canerpotur/TROY-TECH/Spring Semester Test Results/08_04_2019_VideoTransmission_IndoorRangeTest_Successful.JPG

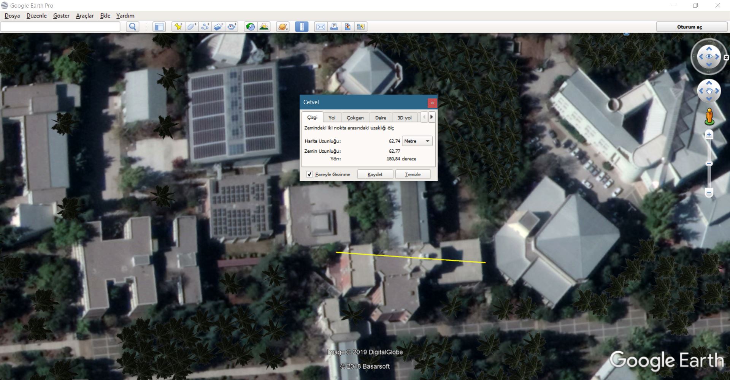
Spring Semester Test Results/08_04_2019_VideoTransmission_IndoorRangeTest_Successful.JPG
