canerpotur/TROY-TECH/Tests/Range performance  Video+command  tests/Photos (Google Earth)/D_E_command.JPG

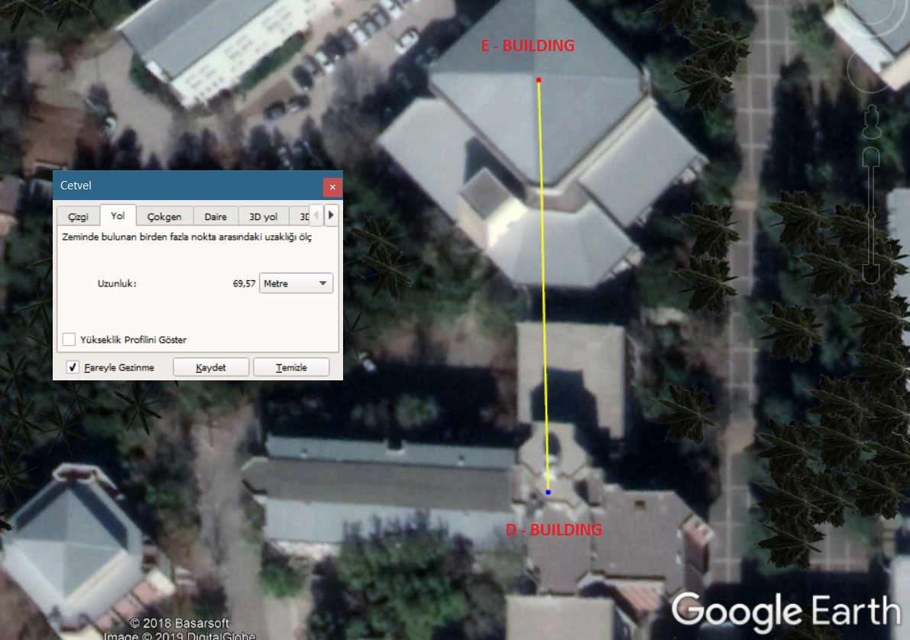
Tests/Range performance Video+command tests/Photos (Google Earth)/D_E_command.JPG
