canerpotur/TROY-TECH/README.md

# TROY-TECH
METU EE 2018-2019 GRADUATION PROJECT
