canerpotur/TROY-TECH/Demo/motor/useful link for motor drive.txt

https://howtomechatronics.com/tutorials/arduino/arduino-dc-motor-control-tutorial-l298n-pwm-h-bridge/
