canerpotur/TROY-TECH/Searches/Wireless Transmission/HC-12/links.txt

https://forum.arduino.cc/index.php?topic=499210.0
