canerpotur/TROY-TECH/Weekly Reports/Week4(October29-November6)/TroyTech-WeeklyReport4.docx

MIDDLE EAST TECHNICAL UNIVERSITY

DEPARTMENT OF ELECTRICAL & ELECTRONICS ENGINEERING


TROY TECH

WEEKLY REPORT #4

29.10.2018-06.11.2018

Section : 7

Studio Coordinator: Mustafa Mert ANKARALI

Partners :

Hasan ÖZKARA - 2031888

Kağan ÖZASLAN - 2031854

Caner POTUR - 2031250

Mustafa Ercan OKATAN - 2031193

Mert KAYIŞ – 2030997

Progresses for Previous Week:

→ We started working on the proposal report that we will submit on November 9th. Firstly, we tried to understand the function of the proposal report, we discussed about how the outline of the proposal report should be. We discussed on the description of proposal report on the course website.

→ We distributed the main parts of the work load to our group members according to their tendancies about parts of the project such as wireless communication, motor driving units and mechanics. As shown in Table 1, we tried to share the total work load of the project.

Table 1: Distribution of the work load between group members.

| Main Option | Secondary Option
Caner POTUR | Video Transmission | Command Transfer
Mert KAYIŞ | Video Transmission | Command Transfer
Mustafa Ercan OKATAN | Mechanics | Command Transfer
Hasan ÖZKARA | Motor Drive | Mechanics
Kağan ÖZASLAN | Command Transfer | Motor Drive

Plans for the Next Week:

We are planning to order some hardware parts related to video transmission unit (camera and the necessary units for wireless transfer of the data image) in the following week in order to observe real-life behavior of the stuff that we want to include in our project.

Until Friday, we are going to complete working on deliverables and possible outcomes of the project, tentative cost-budget analysis, Gantt chart (time plan for the rest of the project). Finally, we will submit our proposal report on time.
