canerpotur/TROY-TECH/Troy Tech - Presentation/TROY - Kağan.pptx

## KAĞAN ÖZASLAN CFO

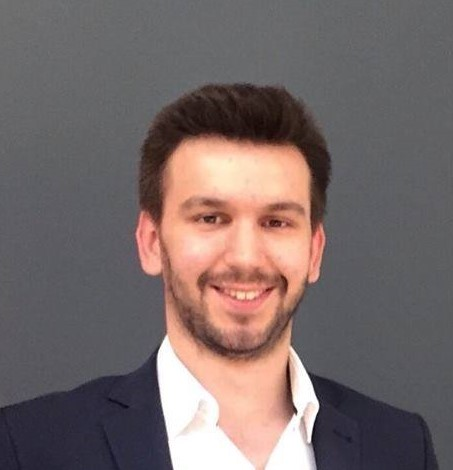
[picture p66: figure]

## Slide 2

- Video Transmission
- Command Transmission

## Video Transmission

- 5.8 Ghz
- 600mw Transmitter (TS5828)
- 40 Channel
- 27.5 dBm
- 170 degree camera

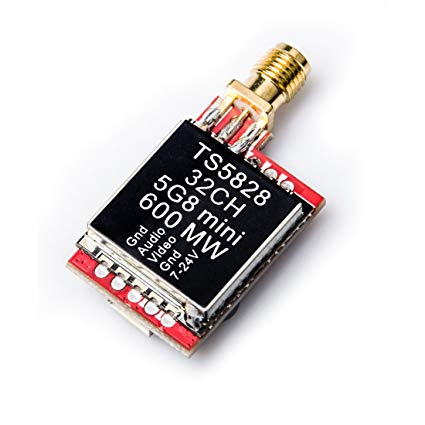
[picture p67: figure]
ts5828 ile ilgili gÃ¶rsel sonucu
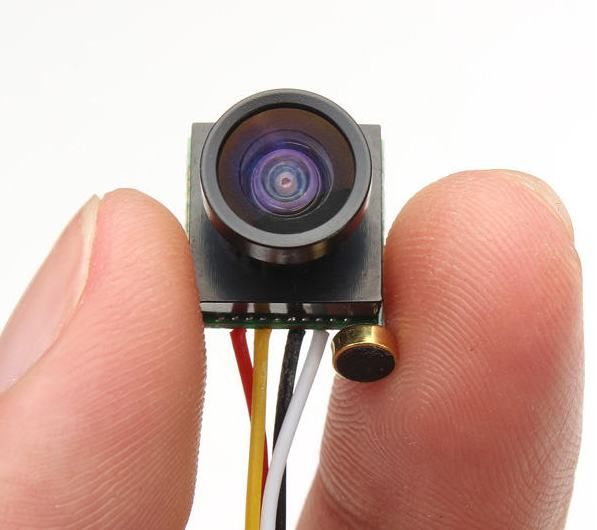
[picture p68: figure]
nesne içeren bir resim Yüksek güvenilirlikle oluşturulmuş açıklama

## Video Transmission

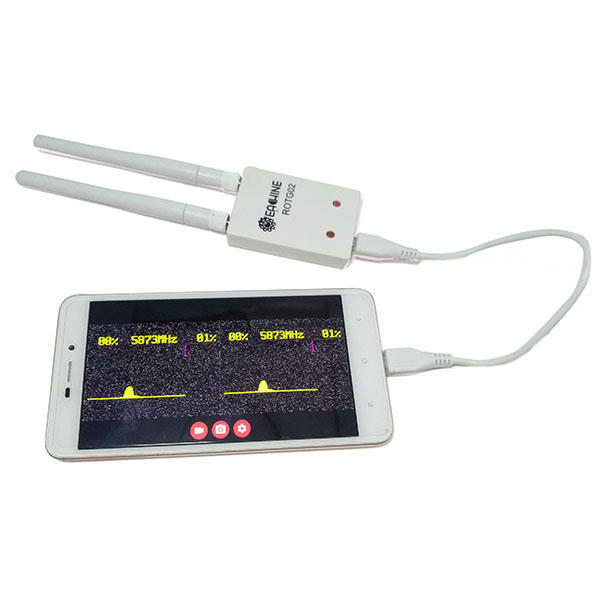
[picture p69: figure]

- 5.8 Ghz Receiver (ROTG02)
- Easy to use
- Plug and Play with usb cable
- 150 Channel

## Test Results

- Outdoor = 500 m
- Indoor = 50 m (from E Building Top Floor to D Building Study Hall)

## Test Results

- Outdoor = 500 m
- Indoor = 50 m (from E Building Top Floor to D Building Study Hall)
- Improvement Option
  - 5.8G Amplifier
  - 27dBm to 34 dBm

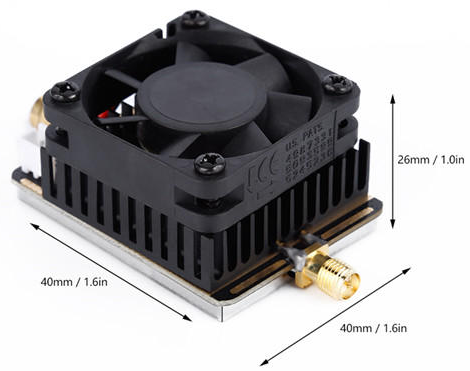
[picture p70: figure]

## Command Transmission

- 2.4Ghz band
- NRF24L01+ module
  - Very cheap (less than $2)
  - Compatible with high gain antennas
  - 2.4ghz antennas are also very cheap
  - Secure communication protocol
  - 100mW, legal to use

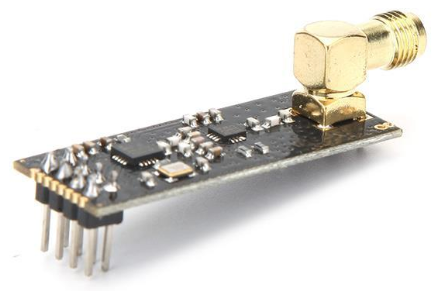
[picture p71: figure]

## Command Transmission

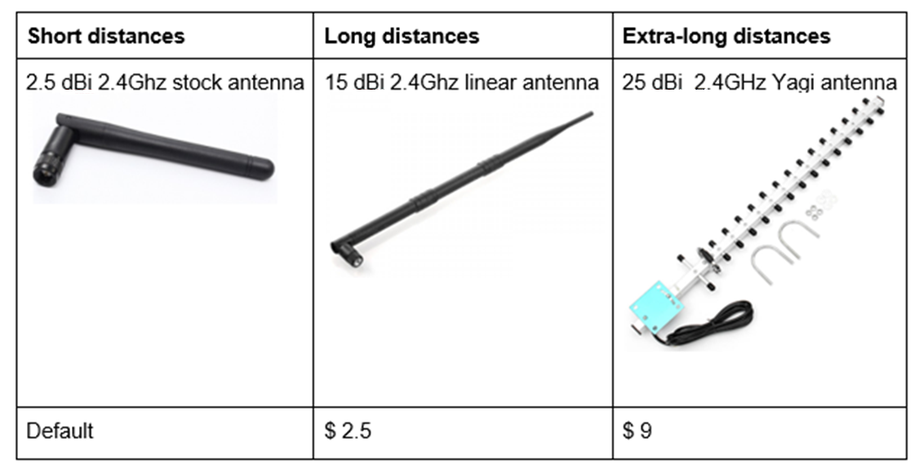
[picture p72: figure]

## Test Results

- NRF modules with 15dBi Linear Antennas
- Outdoor = 1 km
- Indoor = 100 m

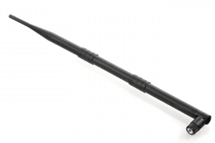
[picture p73: figure]

## Communication Protocol

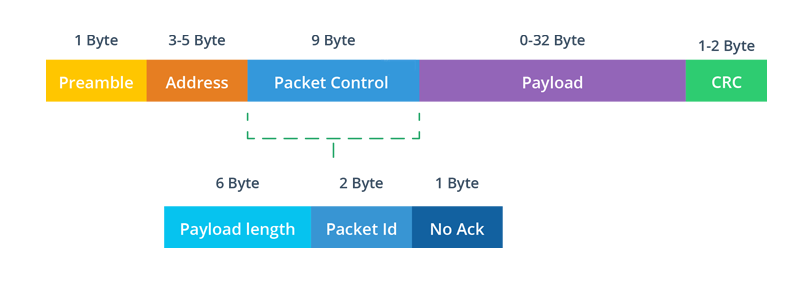
[picture p74: figure]

## Slide 11

Preamble: Shows beginning of a packet.
Address: Shows the network pipe address.
Packet Control: Settings section.
Payload: Sending data is stored inside. Upon 32 byte.
CRC: Cyclic redundancy check for error detection.

## User Side

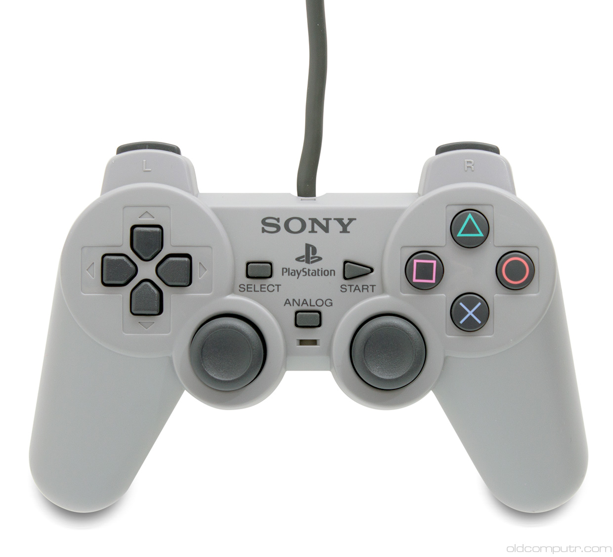
[picture p75: figure]
gök, iç mekan içeren bir resim Yüksek güvenilirlikle oluşturulmuş açıklama
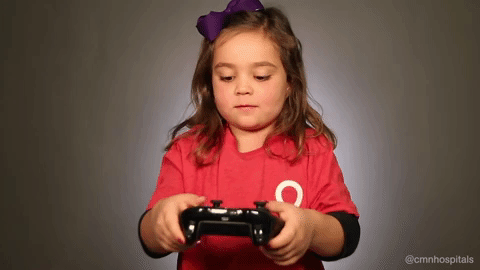
[picture p76: figure]
Video Games Kids GIF by Children's Miracle Network Hospitals
