canerpotur/TROY-TECH/Troy Tech - Presentation/TROY Mert.pptx

CONCEPTUAL DESIGN
PRESENTATION

## MERT KAYIŞ COO

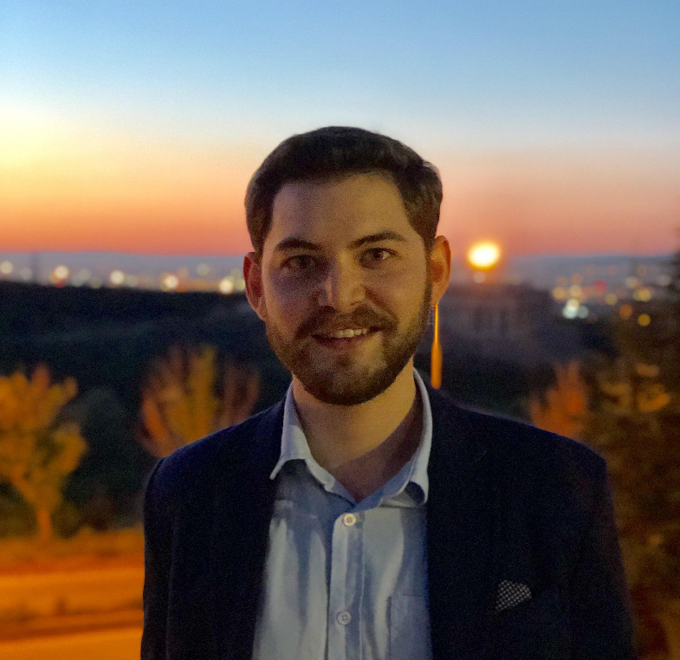
[picture p77: figure]

## Overall Block Diagram

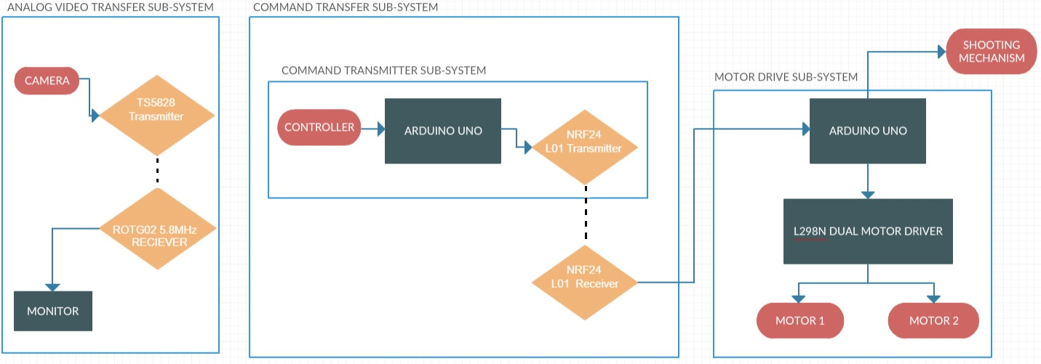
[picture p78: figure]

## Flowchart for Video Transfer Subsystem

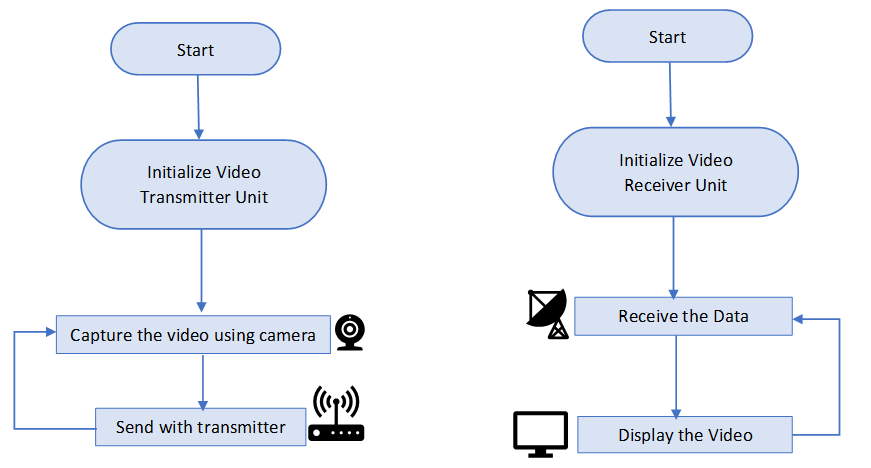
[picture p79: figure]

Continuous operation

Continuous operation

## Flowchart for the Command Transfer Subsystem

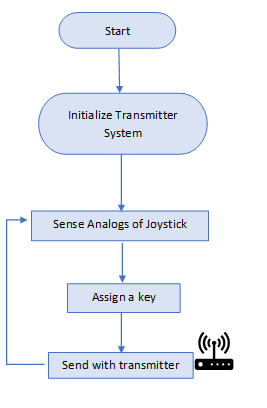
[picture p80: figure]

## Flowchart for the Command Transfer Subsystem

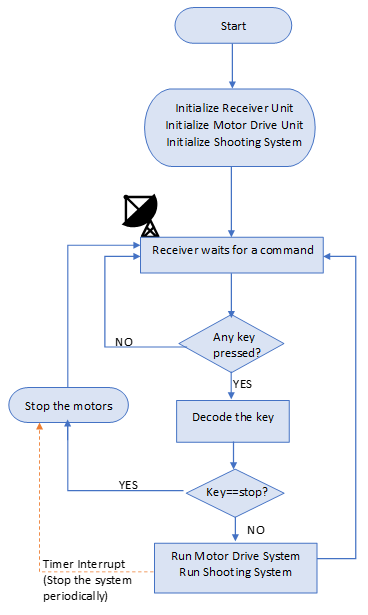
[picture p81: figure]

## Power Supply Unit

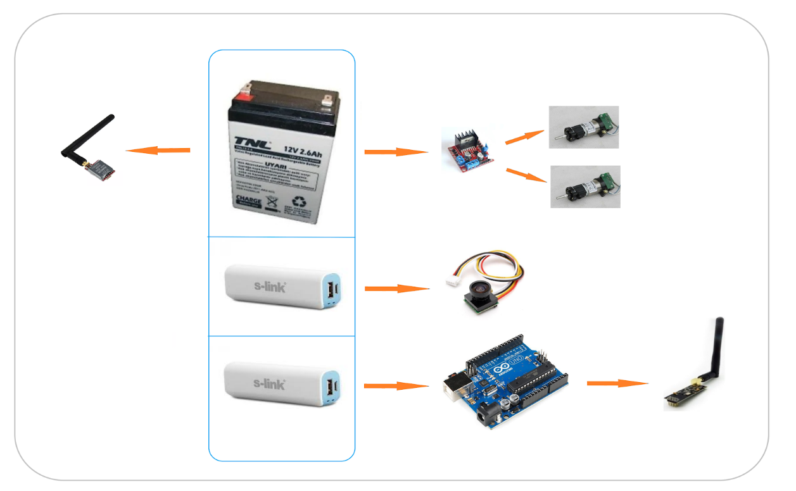
[picture p82: figure]
