canerpotur/TROY-TECH/Troy Tech - Presentation/TROY- Hasan OZKARA.pptx

CONCEPTIAL DESIGN
PRESENTATION

## Hasan ÖZKARA -CEO-

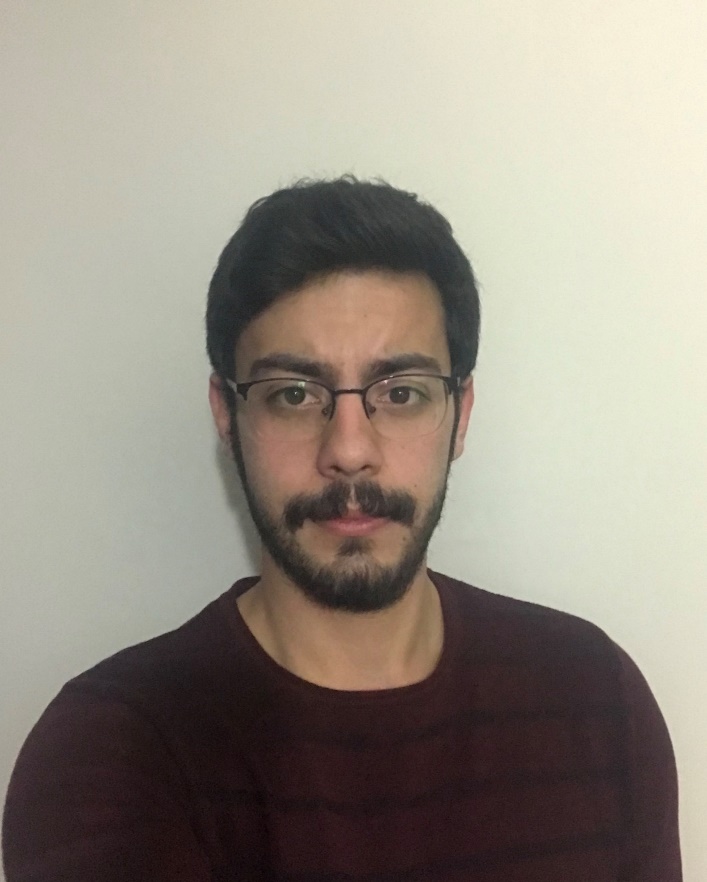
[picture p83: figure]

## Outline of the Presentation

- Company Description
- Introduction
- Overall Block Diagram
- System Level Flowchart
- Power Supply Unit
- Video Transmission
- Command Transmission

## Slide 4

Company Description

## Members of the Company

TROY TECH
CEO
Hasan ÖZKARA
COO
Mert KAYIŞ
CFO
Kağan ÖZASLAN
CMO
Mustafa Ercan OKATAN
CTO
Caner POTUR

## Mission & Vision

- Mission: Our mission is to design and produce creative and reliable electronic Technologies and robotics meeting the desired specifications of customers under limited budget and time.
- Vision: Our vision is to be a unique company consisting of highly motivated R&D engineers that create impressive robotic products with affordable and reasonable costs.

## Product – Helen V

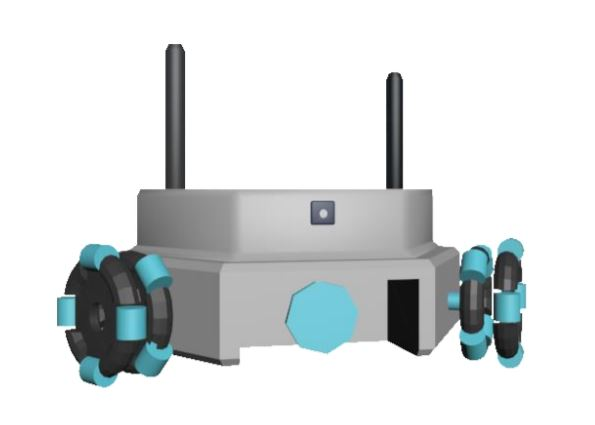
[picture p84: figure]

## Slide 8

Introduction

## Problem Statement

- Controlling the ball
- Shooting the ball to opponent’s goal
- Defending the ball coming from opponent

## Restrictions & Constraints

- Teleoperation from at least 30 meters
- Remote control
- No crossing to the center-line
- No touching to the opponent
- Ball transfer to opponent’s field in 20 seconds
- Only hitting or pushing the ball
- Robot fitting into cylinder of diameter 65cm
- Maximum budget of $200
