canerpotur/TROY-TECH/Searches/DEVICES.docx

DEVICES:

1)

5.8Ghz 600mW FPV transmitter and receiver are seen suitable for our project. Only question is, are they supposed to work indoor? But it most probably could work indoor as well because 600mW transmitter gives 1-2 km range in the open area. It has different channels so that the video cannot be mixed with others broadcast.

This is transmitter and receiver kit is about $25 at aliexpress link (https://tr.aliexpress.com/item/FPV-5-8Ghz-600mW-TS5828-or-TS832-Transmitter-48CH-RC832-plus-Receiver-With-A-V-and/32813251539.html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).

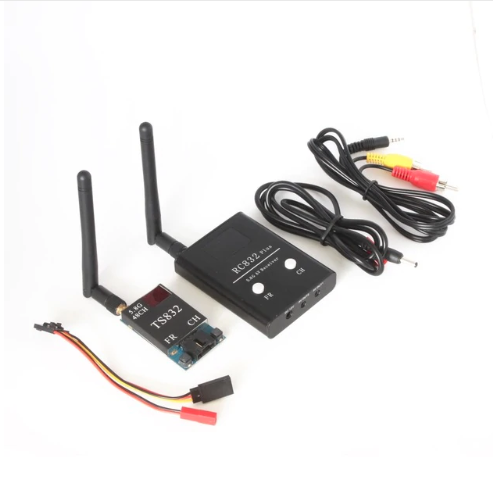
[picture p85: figure]

UPDATE:

We’ve orderred ROTG02 from bangood.com as $21. Order date: 12.11.2018

https://www.banggood.com/Eachine-ROTG02-UVC-OTG-5_8G-150CH-Dual-Antenna-Audio-FPV-Receiver-for-Android-Tablet-Smartphone-p-1242422.html?ID=224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

Here is some testing examples of it.

https://www.youtube.com/watch?v=I2rOh4Psi1I

2) OMNI WHEEL

We can use omniwheel for our robot to be able to capable for moving all directions. There is some example video and brief introduction below about omniwheel and also a detailed article is attached into the TROY-TECH\Searches folder. There may be some issues by using omniwheel; it increases expenses directly and omni wheels are not cheap. We also should handle controlling them, maybe with a feedback control system.

1st video : https://www.youtube.com/watch?v=_tmiu1wpp_E

2nd video : https://www.youtube.com/watch?v=H29PEOTDFA4

Here is brief introduction of omni-wheel technology.

Omni-directional wheels are unique as they are able to roll freely in two directions .It can ether roll like a normal wheel or roll laterally using the wheels along its circumference.Omni-direction wheels allow a robot to convert from a non-holonomic to a holonomic robot.A non-holonomic robot that uses normal wheels has only 2 out of 3 controllable degrees-of-freedom which are,moving forward/backwards and rotation.Not being able to move side ways makes a robot slower and less efficient in reaching its given goal. The holonomic omni-directional wheels are able to overcome this problem,as it it a highly maneuverable.Unlike normal non-holonomic robot,the holonomic omni-directional robot can move in an arbitrary direction continuously without changing the direction of the wheels.It can move back and forth,slidewaysmand rotates at the same position.

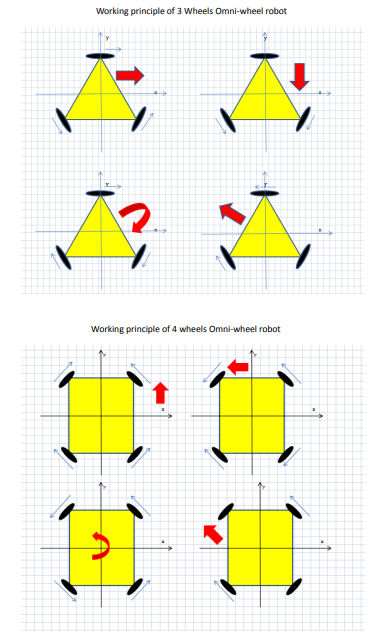
[picture p86: figure]

3) Micro camera with FPV transmission(Fig. 1.)

Price:$11.49 (www.aliexpress.com)

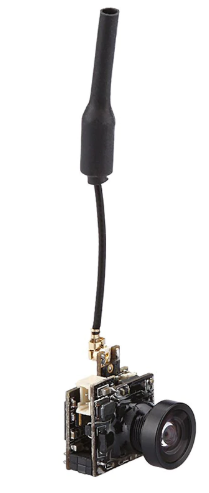
[picture p87: figure]

Features:

-Sensor: 1/4" CMOS

-Lens: M8 800 TVL lens

-Angle: 150° horizontal viewing angle and 170° viewing angle

-Format: NTSC / PAL (switchable)

-Power consumption: 380mA@ 3.7 v

-Voltage: 3.6 - -5.5 v

-Lens Mirror Diameter: 2.1mm FOV 150° (horizontal)

-Video transmitter

-Support video formats: NTSC / PAL

-Output impedance: 75 ohms

-Output signal strength: 23 ~ 24 dbm

-Output power: 25 mw

-Wireless channel: 40 ch

-Operating voltage: 3.6 v ~ 5.5 v

Eachine FPV receiver(Fig. 2.)

Price:$17.5 (www.banggood.com)

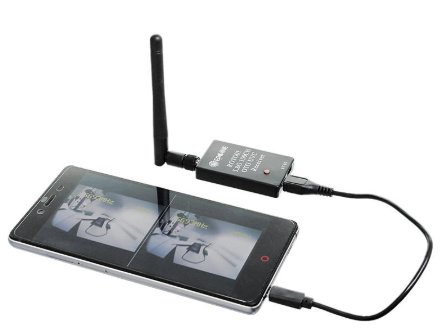
[picture p88: figure]

Features:

-Brand: Eachine

-Model: ROTG01

-Name: UVC OTG FPV Receiver

-Channel : 150CH

-Frequency Range: 5645~5945

-Sensitivity: -90dBm

-Working Current: 200mA/5V

-Power Supply: 5V(by smart phone)

-Operating Temperature: -10~60℃

-Connector: RP-SMA Female

-Weight: About 28g
