canerpotur/TROY-TECH/Searches/Wireless Transmission/Avoiding interference in 2.4GHz.docx

We are planning to use RC remote control devices as the command transmitter unit. They generally work about 2.4GHz band. We need to be sure that they do not interfere and coincide.

Link to the related articles:

https://www.eetimes.com/document.asp?doc_id=1273359&page_number=1

https://www.networkworld.com/article/2215287/tech-primers/coping-with-wi-fi-s-biggest-problem--interference.html
