canerpotur/TROY-TECH/Semester Break Progress Reports/Hasan OZKARA report.pdf

## AFTER DEMONSTRATION PROGRESS REPORT

Hasan OZKARA 2031888

As a group:

- We decided to focus on improving our project.
- We worked on obtaining wider and advanced communication, smarter physical design and shooting mechanism.
- We reviewed previous reports and researches.

As an individual:

- I worked on motor part of our project.
- Our motors have encoder option, but we did not use it yet. Therefore, I focused on that subject.
- Encoder is responsible of controlling speed of motor.

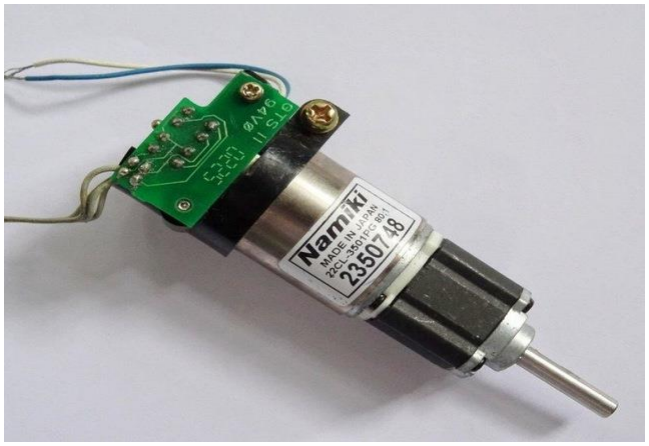
[picture p162: figure]

- Also, I worked on controller types during EE407 lab project. After demonstration, I kept working on this subject. This may contribute better movement of our robot and supply remote option.
