canerpotur/TROY-TECH/Semester Break Progress Reports/Ercan Okatan_report.pdf

Mustafa Ercan OKATAN

2031193

### SEMESTER BREAK REPORT

In the first semester ,we had completed most of the parts of the project except the shooting mechanism. My main focus at the semester break was on the shooting systems. We had proposed three different methods for shooting mechanism: solenoid, spring and pneumatic.

I prefer using solenoid system since it will provide powerful shooting and it is easy to control and operate.

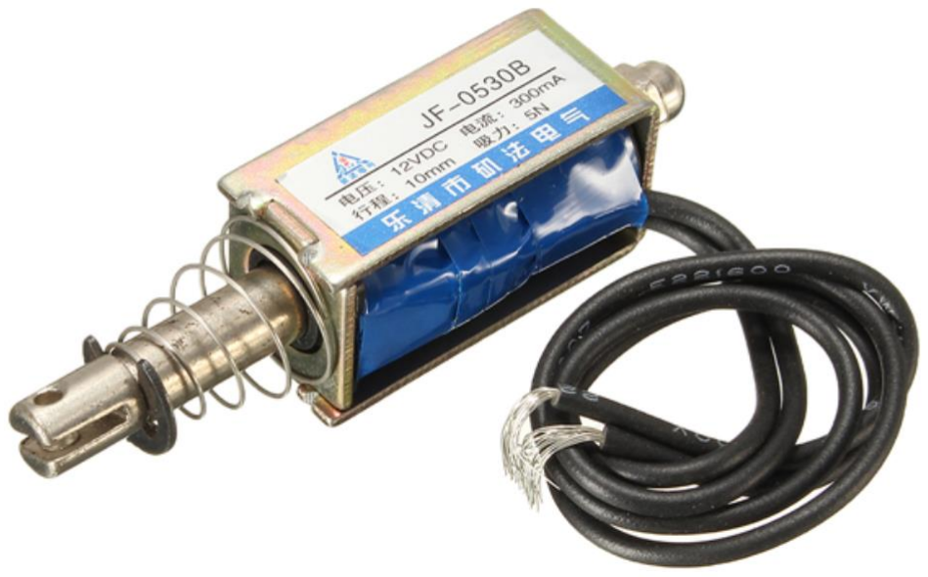
[picture p163: figure]

We can operate the system with the voltage control. We can use digital output of the arduino for 12V pushing and for 0V pulling. We can use very simple circuit for drive the solenoid through arduino.

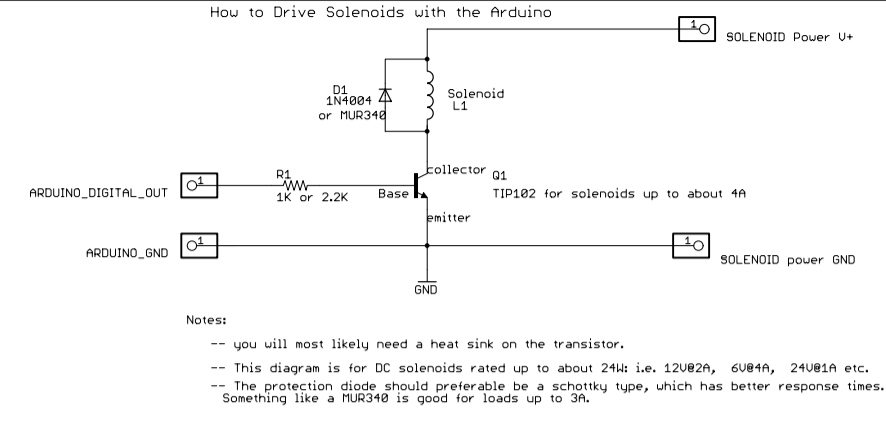
[picture p164: figure]

Above circuit can be used for this purpose. We may encounter heating prolem and thus, we can use heat sink.

We can establish a much more complex shooting system constisting of three selonoid.

The cost of the push and pull solenoids are just 5 dollar.
