canerpotur/TROY-TECH/Searches/S-link.pdf

### S-link Powerbank

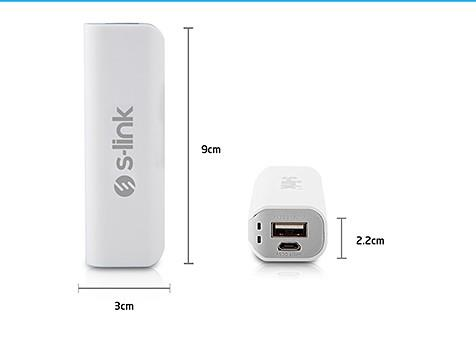
[picture p223: figure]

- Capacity: 2000 mAh
- Input: 5V / 1A
- Output: 5V / 1A
- Li-On Battery
- Dimension: 90 x 28 x 22 mm
