canerpotur/TROY-TECH/Searches/shooting systems/Solenoid Comparison.pdf

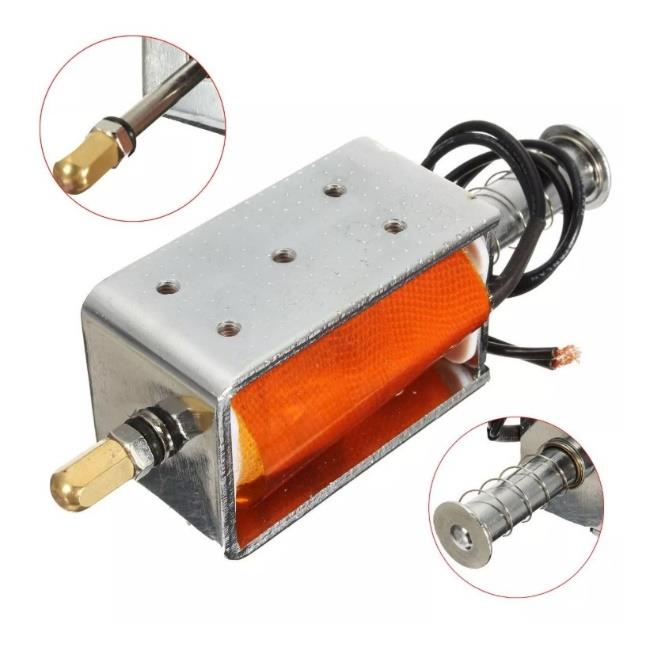
[picture p224: figure]

- Rated Voltage: DC 12V
- Rated Current: 8A
- Stroke: 35 mm
- Body Size: 64 x 32 x 38 mm

## Comparison of Solenoids

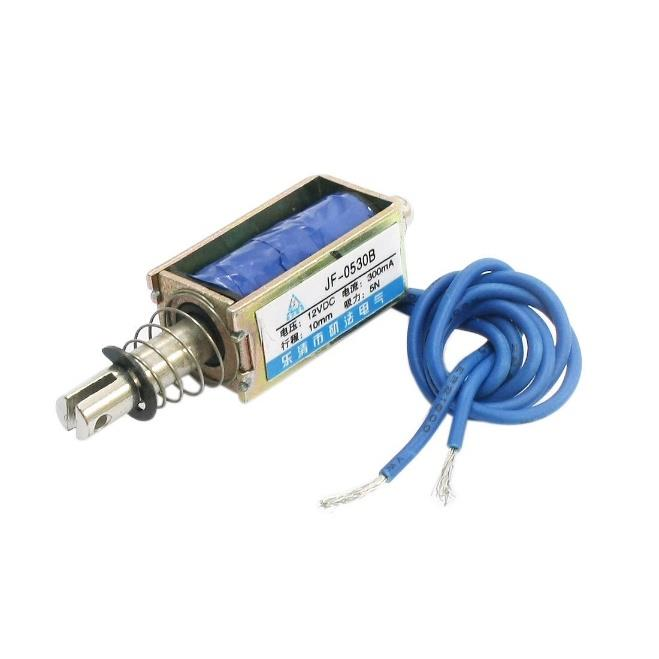
[picture p225: figure]

- Rated Voltage: DC 12V
- Rated Current: 300mA
- Stroke: 10 mm
- Body Size: 30 x 15 x 15 mm
