canerpotur/TROY-TECH/Searches/shooting systems/Solenoid Circuit Example.pdf

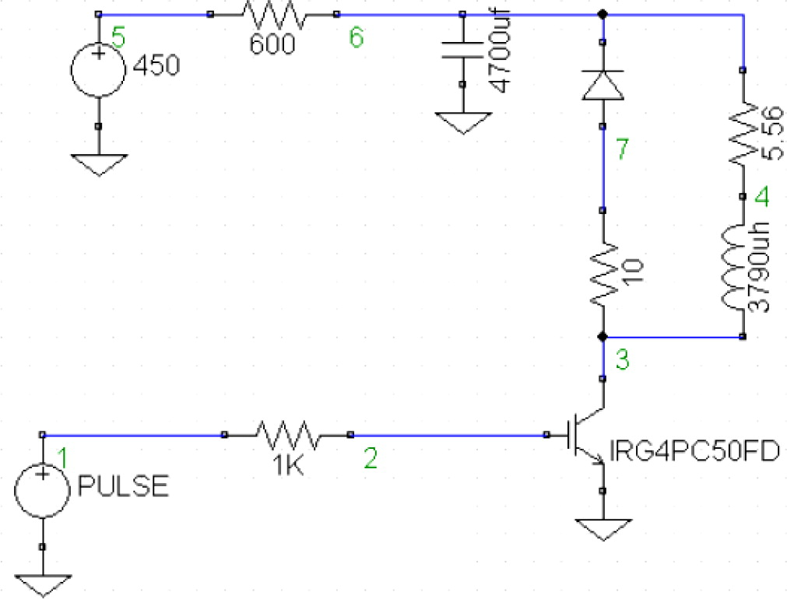
[picture p226: figure]

Fig. 10. Solenoid controlling circuit © 2010 by SAGE Publications Ltd, unless otherwise noted. Manuscript content on this site

is licensed under Creative Commons Licenses.
