canerpotur/TROY-TECH/Drawings/PowerSupply_Figure.docx

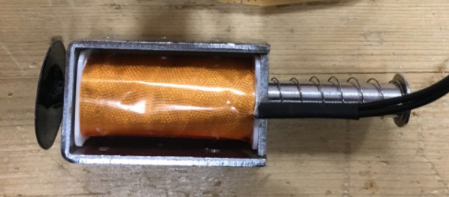
[picture p234: figure]
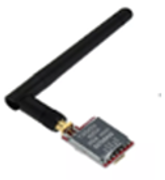
[picture p235: figure]
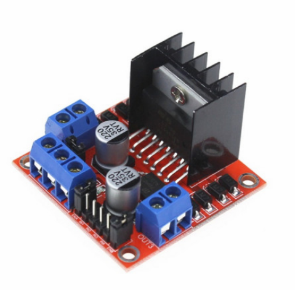
[picture p236: figure]
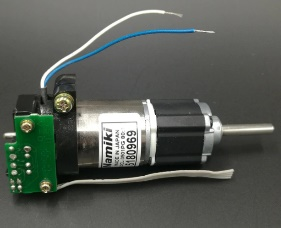
[picture p237: figure]
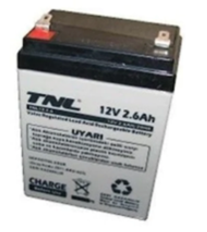
[picture p238: figure]
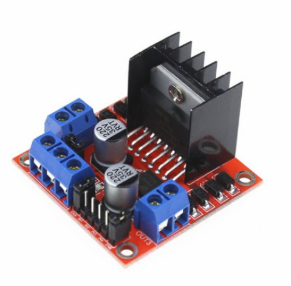
[picture p239: figure]
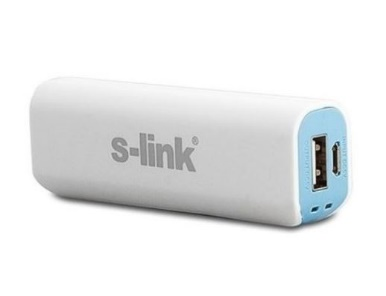
[picture p240: figure]
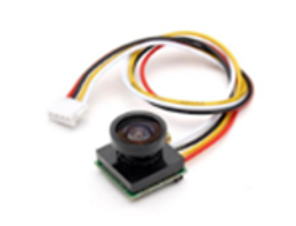
[picture p241: figure]
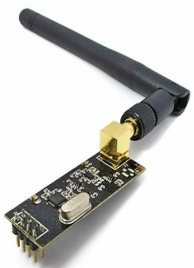
[picture p242: figure]
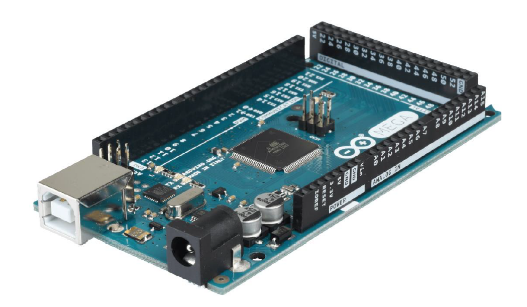
[picture p243: figure]
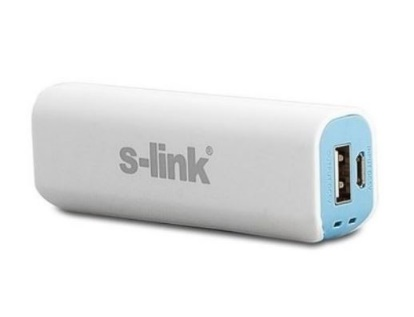
[picture p244: figure]
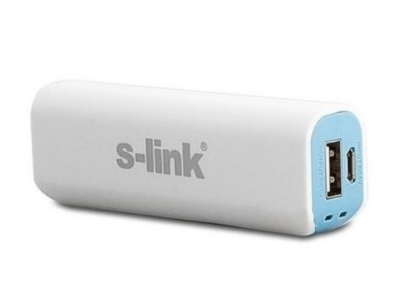
[picture p245: figure]
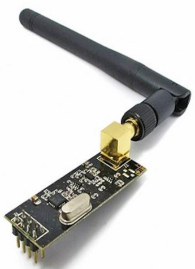
[picture p246: figure]
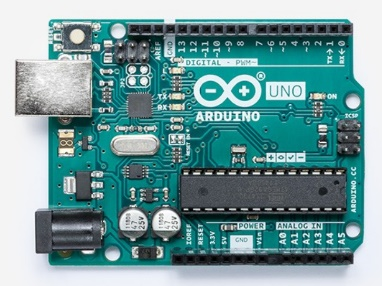
[picture p247: figure]
