canerpotur/TROY-TECH/Troy Tech - Presentation/TROY- Hasan OZKARA_yeni.pptx

CONCEPTUAL DESIGN
PRESENTATION

## Hasan ÖZKARA -CEO-

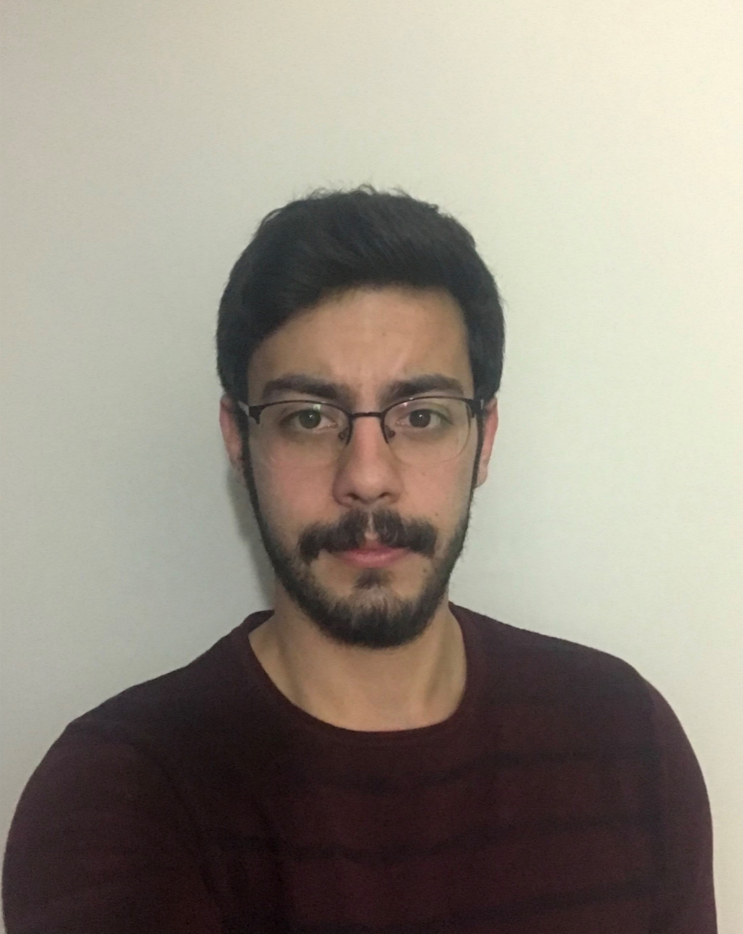
[picture p248: figure]

## Outline of the Presentation

- Company Description
- Introduction
- Overall System Components
- Video and Command Data Transmission
- Motor Drive and Shooting Systems
- Conclusion

## Slide 4

Company Description

## Members of the Company

TROY TECH
CEO
Hasan ÖZKARA
COO
Mert KAYIŞ
CFO
Kağan ÖZASLAN
CMO
Mustafa Ercan OKATAN
CTO
Caner POTUR

## Mission & Vision

- Mission: Our mission is to design and produce creative and reliable electronic Technologies and robotics meeting the desired specifications of customers under limited budget and time.
- Vision: Our vision is to be a unique company consisting of highly motivated R&D engineers that create impressive robotic products with affordable and reasonable costs.

## Slide 7

Introduction

## Problem Statements

- Controlling the ball
- Shooting the ball to opponent’s goal
- Defending the ball coming from opponent

## Restrictions & Constraints

- Teleoperation from at least 30 meters
- Remote control
- No crossing to the center-line
- Ball transfer to opponent’s field in 20 seconds
- Robot fitting into cylinder of diameter 65cm
- Maximum budget of $200

## Objectives

- Objectives with regard to performance
- Objectives with regard to marketing

## Slide 11

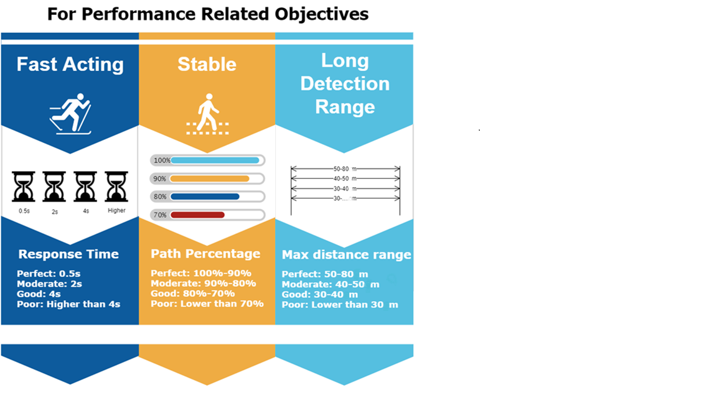
[picture p249: figure]

## Slide 12

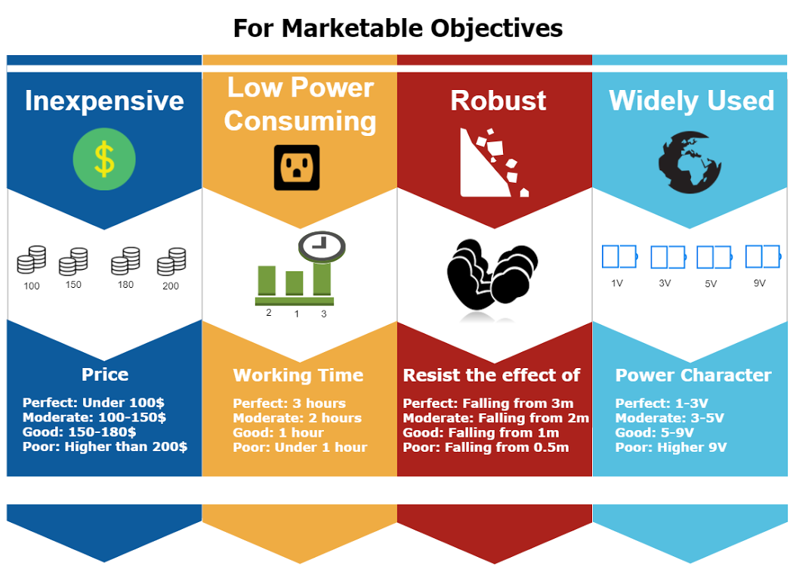
[picture p250: figure]
Marketable Metrics
