canerpotur/TROY-TECH/Troy Tech - Presentation/TROY.pptx

CONCEPTIAL DESIGN
PRESENTATION

## Slide 2

## Slide 3

## Slide 4

## Slide 5

## Slide 6

## Slide 7
