canerpotur/TROY-TECH/Searches/Wireless Transmission/APC220/PL2303USB driver/-×Í++«¬-.pdf

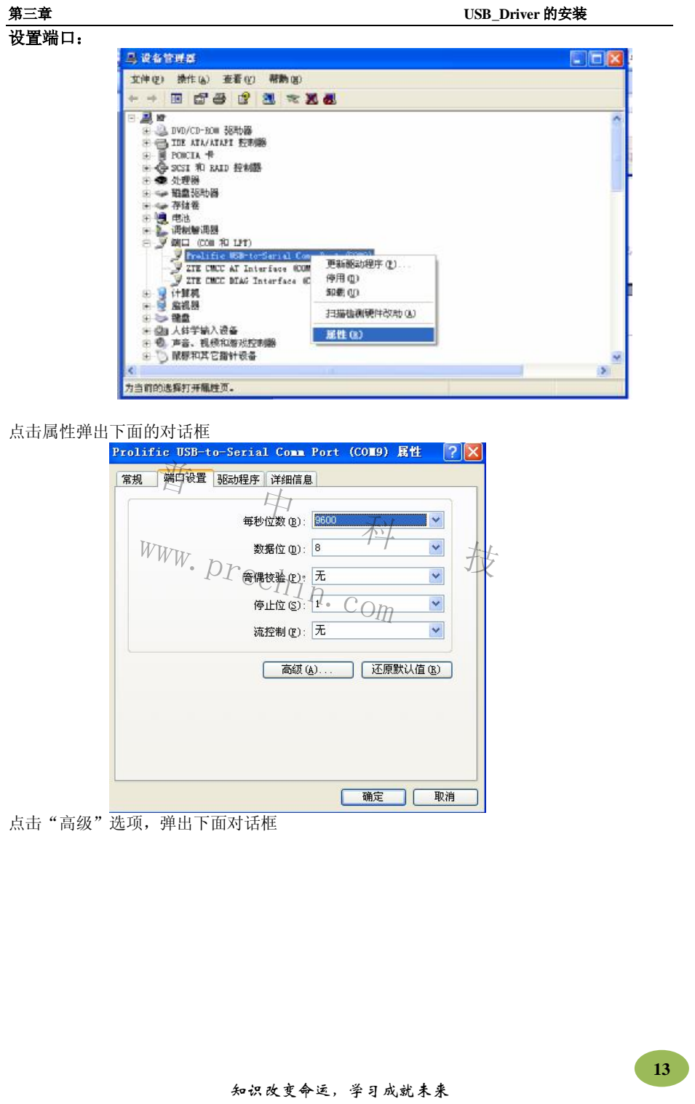
[picture p251: page 1]

第三章 | USB_Driver 的安装

知识改变命运，学习成就未来

13

设置端口：

点击属性弹出下面的对话框

点击“高级”选项，弹出下面对话框

# 普 中 科 技

# www.prechin.com

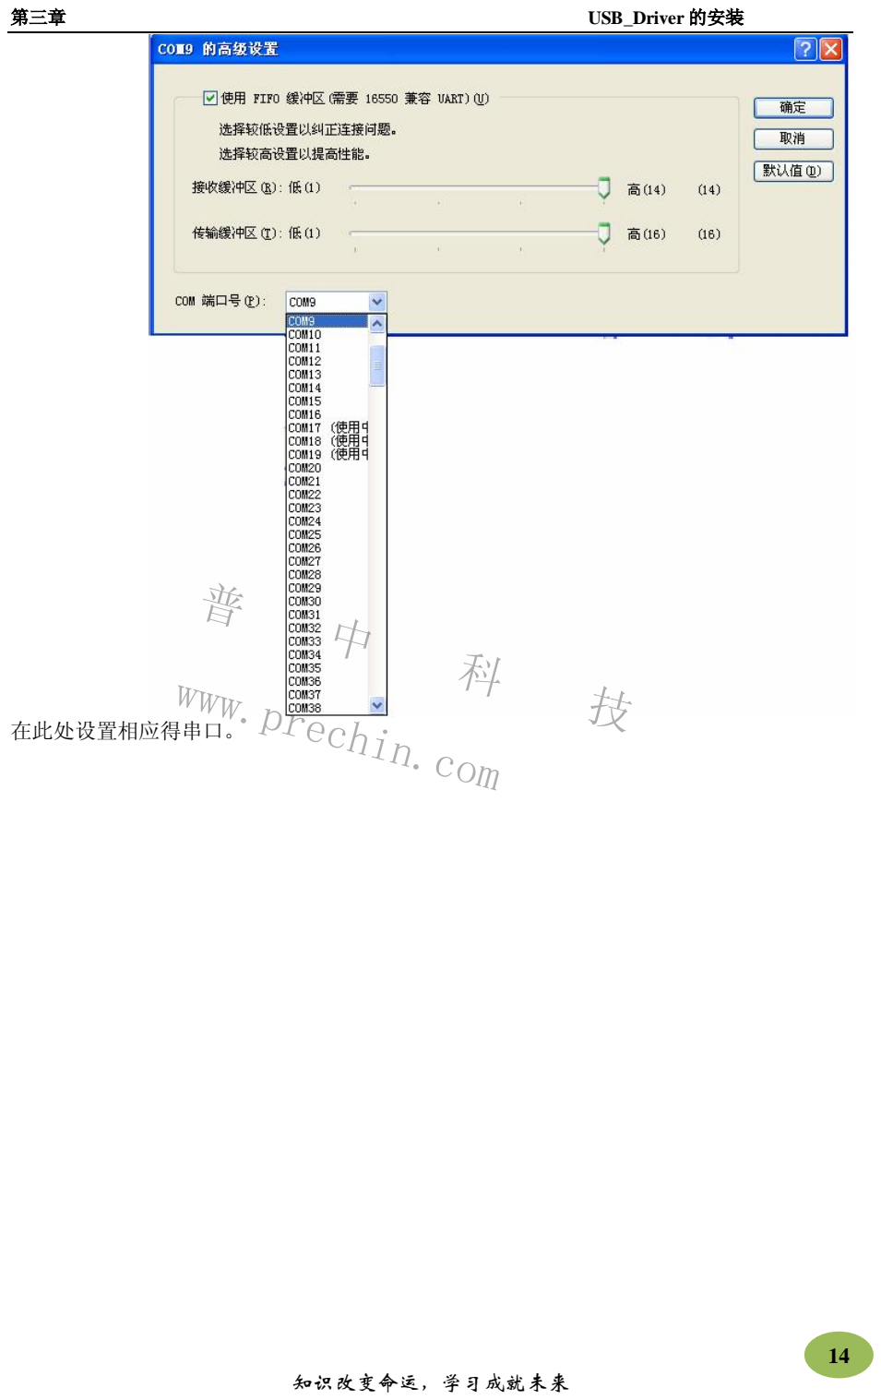
[picture p252: page 2]

第三章 | USB_Driver 的安装

知识改变命运，学习成就未来

14

在此处设置相应得串口。

# 普 中 科 技

# www.prechin.com
