canerpotur/TROY-TECH/Camera Views/Forward_view1.jpeg

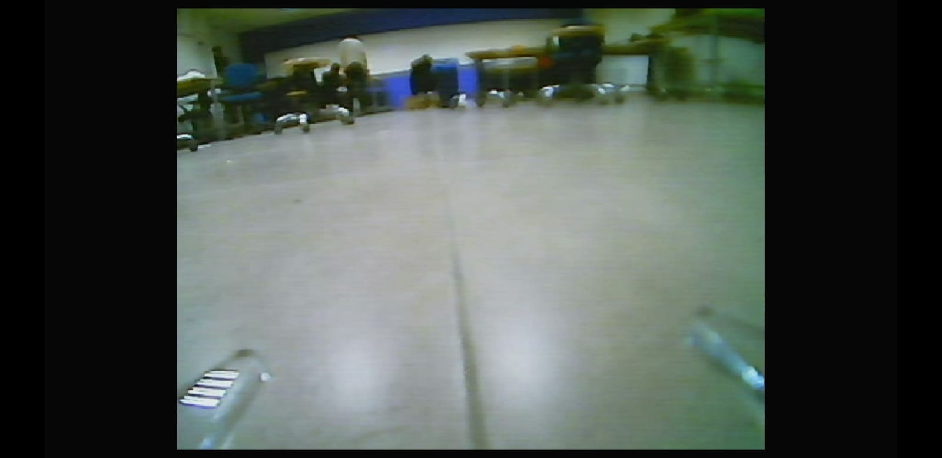
Camera Views/Forward_view1.jpeg
