canerpotur/TROY-TECH/Camera Views/forward_view2.jpeg

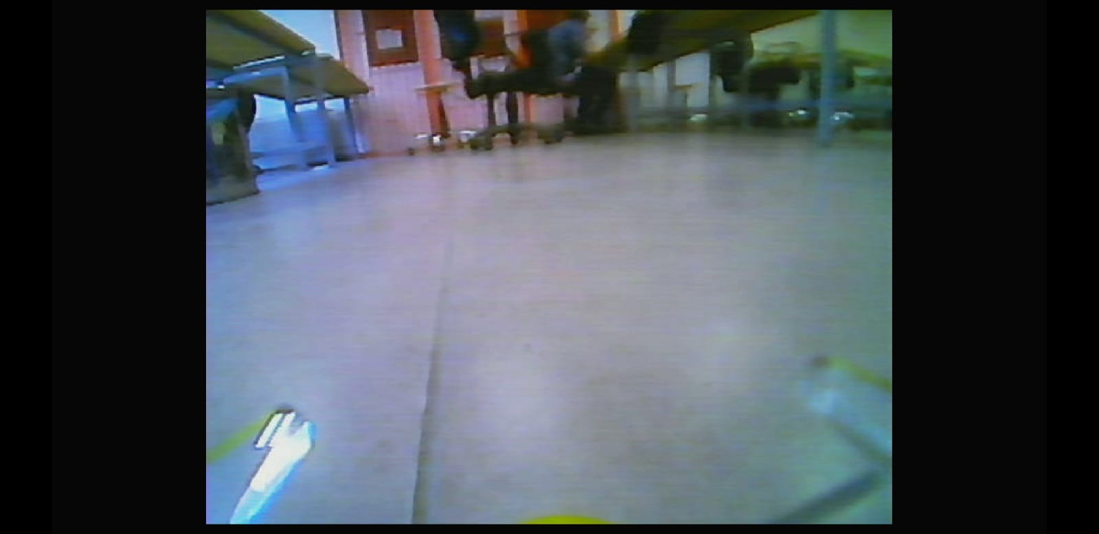
Camera Views/forward_view2.jpeg
