canerpotur/TROY-TECH/Drawings/arrow.PNG

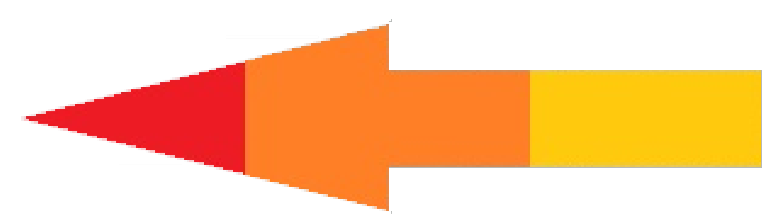
Drawings/arrow.PNG
