canerpotur/TROY-TECH/Drawings/backhelen.JPG

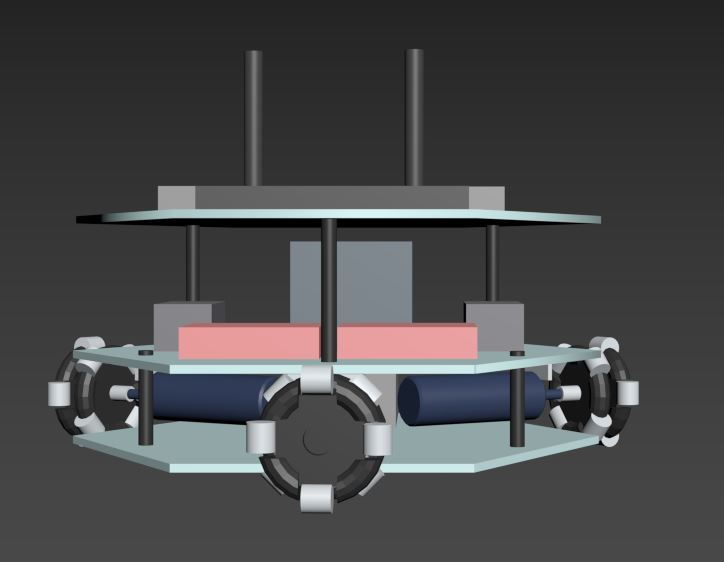
Drawings/backhelen.JPG
