canerpotur/TROY-TECH/Drawings/CDRR drawings/3ç.PNG

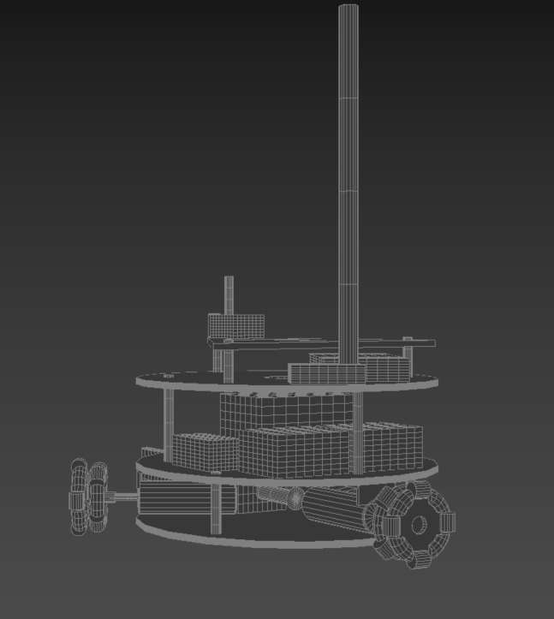
Drawings/CDRR drawings/3ç.PNG
