canerpotur/TROY-TECH/Drawings/CDRR drawings/4ç.PNG

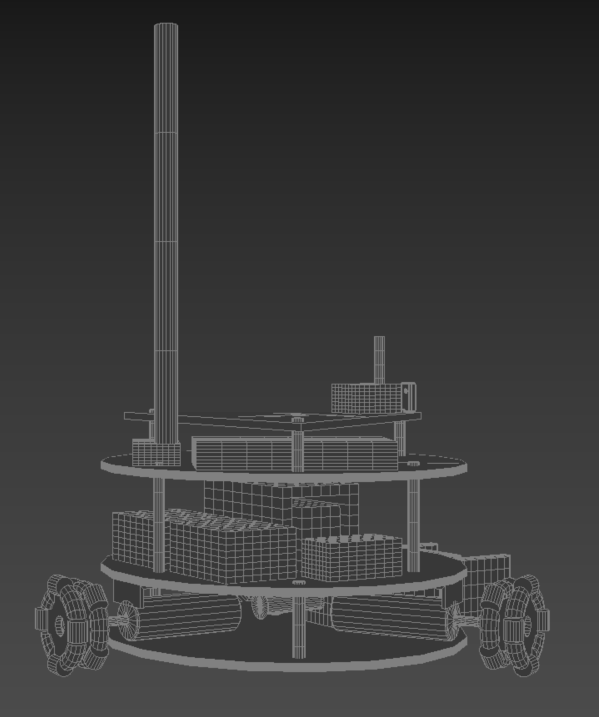
Drawings/CDRR drawings/4ç.PNG
