canerpotur/TROY-TECH/Drawings/CDRR drawings/back.PNG

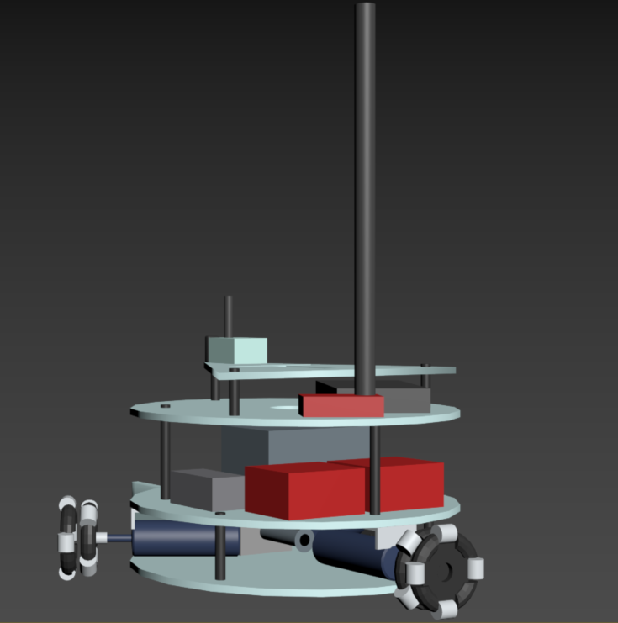
Drawings/CDRR drawings/back.PNG
