canerpotur/TROY-TECH/Drawings/CDRR drawings/bb.PNG

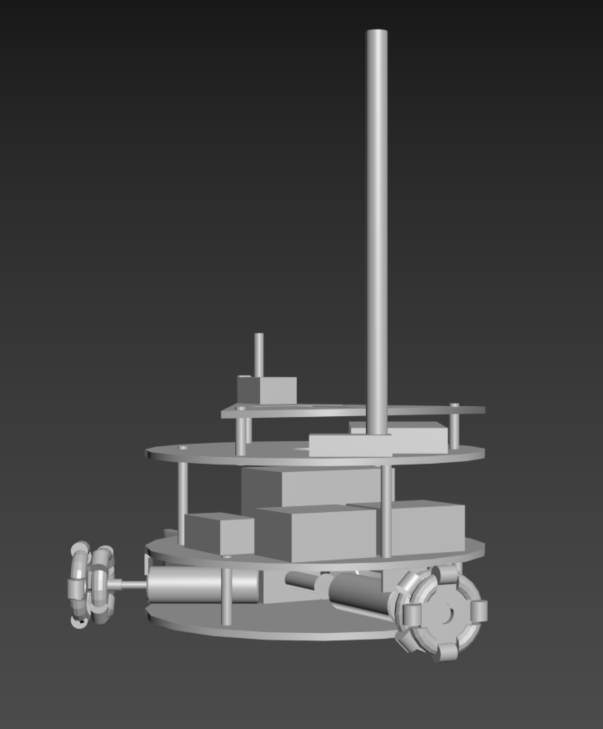
Drawings/CDRR drawings/bb.PNG
