canerpotur/TROY-TECH/Drawings/CDRR drawings/bot.PNG

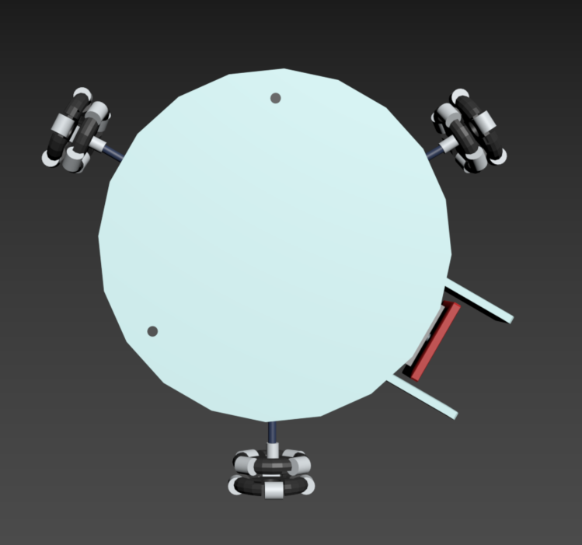
Drawings/CDRR drawings/bot.PNG
