canerpotur/TROY-TECH/Drawings/CDRR drawings/botb.PNG

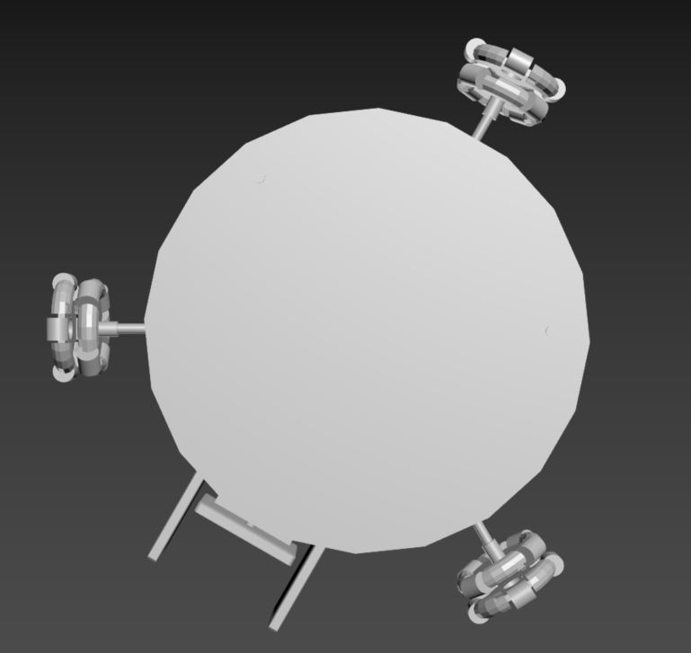
Drawings/CDRR drawings/botb.PNG
