canerpotur/TROY-TECH/Drawings/CDRR drawings/f.PNG

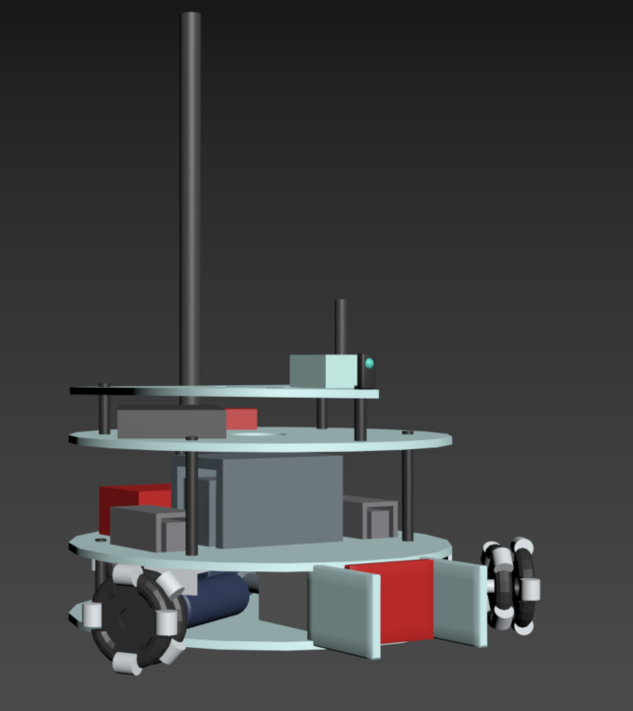
Drawings/CDRR drawings/f.PNG
