canerpotur/TROY-TECH/Drawings/CDRR drawings/fb.PNG

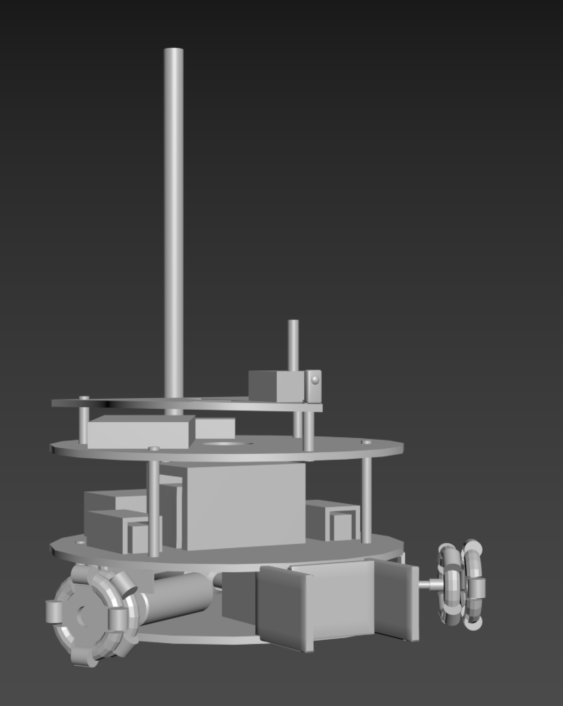
Drawings/CDRR drawings/fb.PNG
