canerpotur/TROY-TECH/Drawings/CDRR drawings/lb.PNG

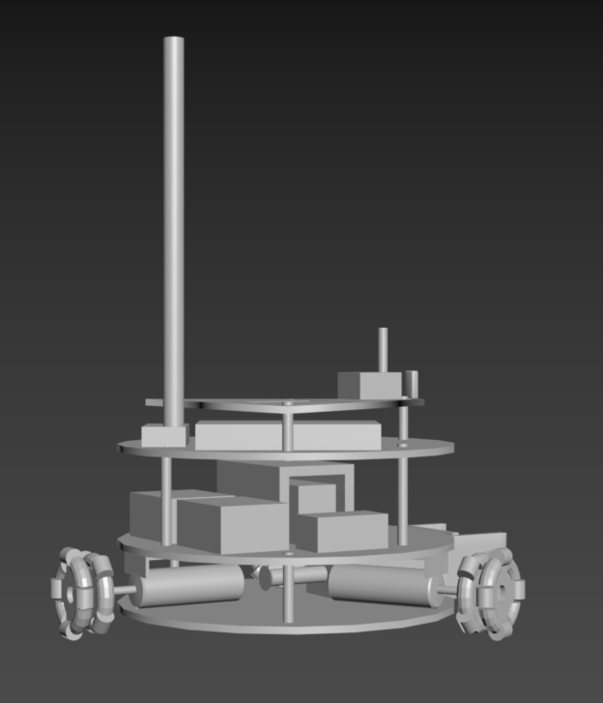
Drawings/CDRR drawings/lb.PNG
