canerpotur/TROY-TECH/Drawings/CDRR drawings/left.PNG

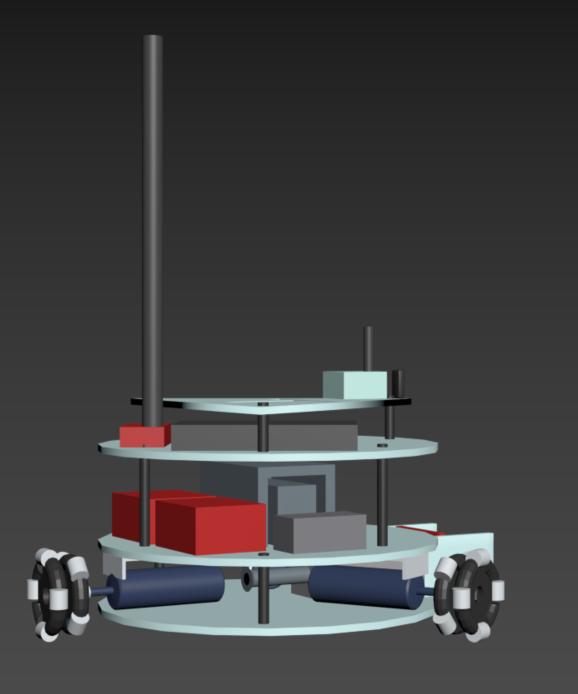
Drawings/CDRR drawings/left.PNG
