canerpotur/TROY-TECH/Drawings/CDRR drawings/rb.PNG

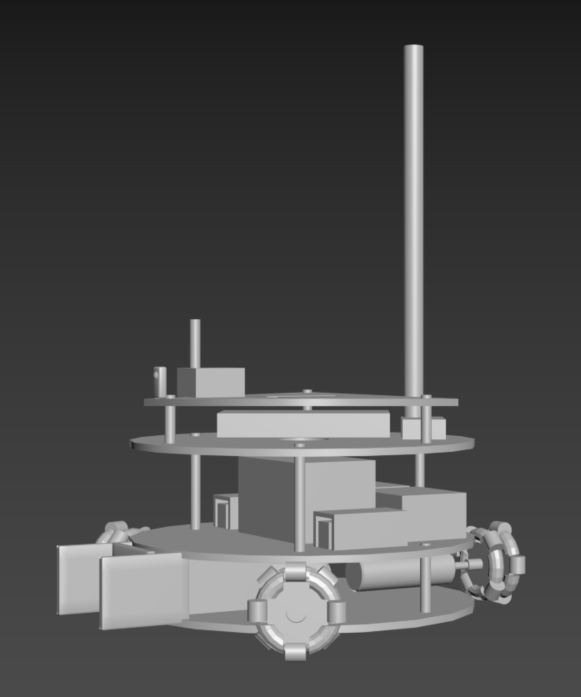
Drawings/CDRR drawings/rb.PNG
