canerpotur/TROY-TECH/Drawings/CDRR drawings/right.PNG

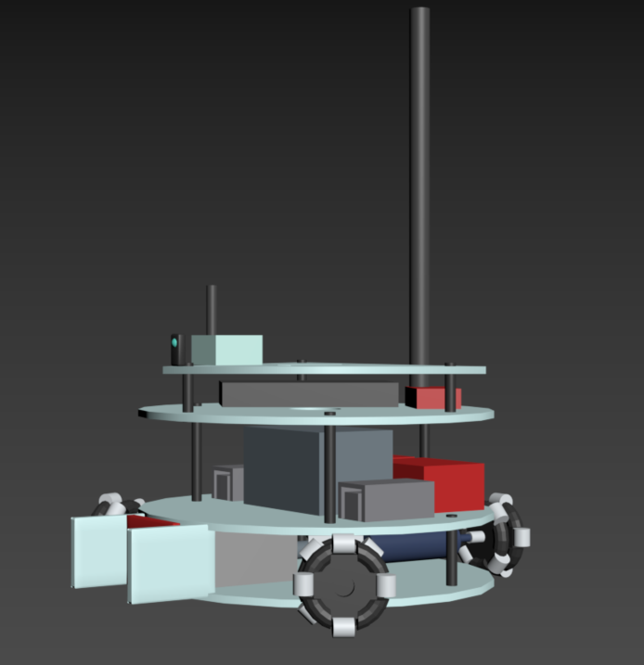
Drawings/CDRR drawings/right.PNG
