canerpotur/TROY-TECH/Drawings/CDRR drawings/t.PNG

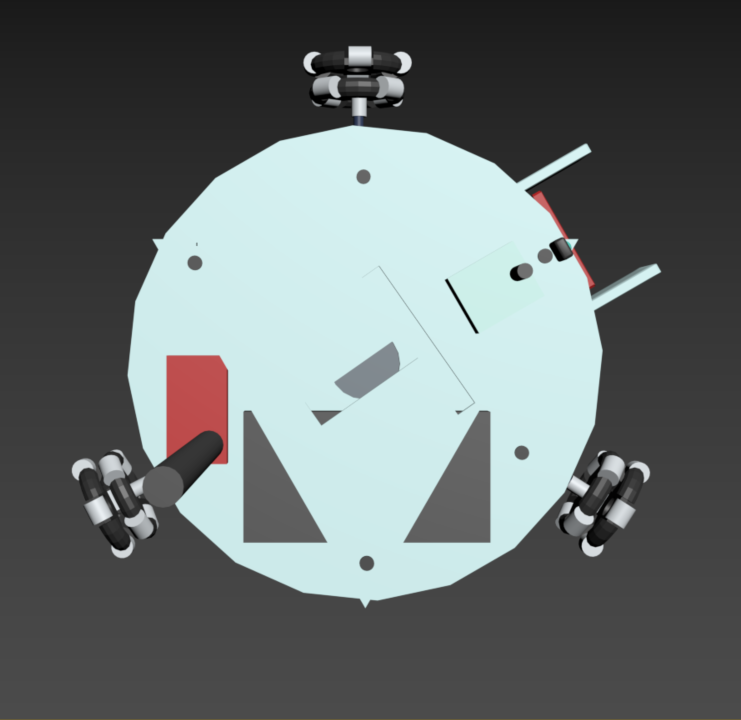
Drawings/CDRR drawings/t.PNG
