canerpotur/TROY-TECH/Drawings/CDRR drawings/tb.PNG

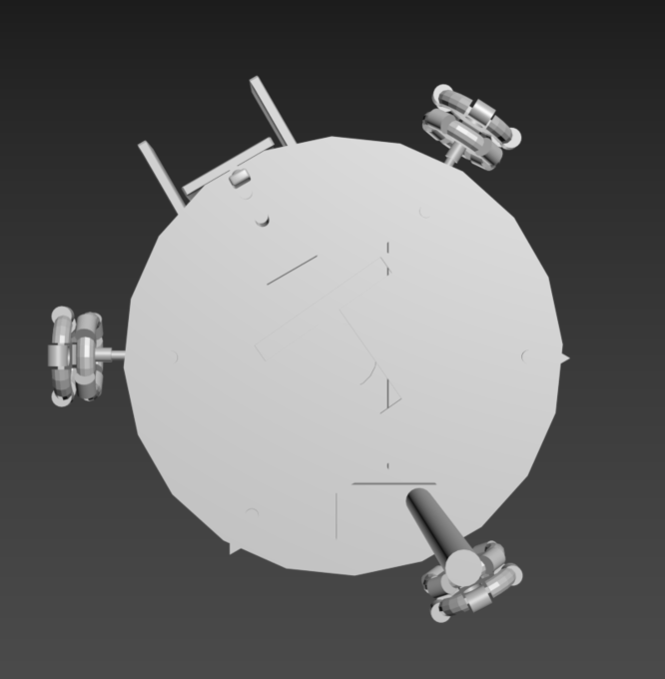
Drawings/CDRR drawings/tb.PNG
