canerpotur/TROY-TECH/Drawings/differential-drive.jpg

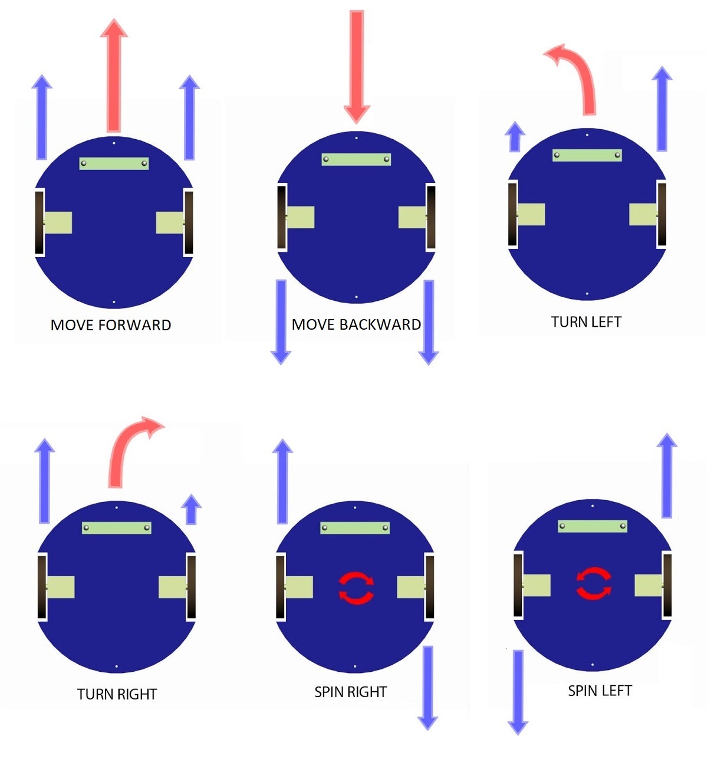
Drawings/differential-drive.jpg
