canerpotur/TROY-TECH/Drawings/flowchart_video.PNG

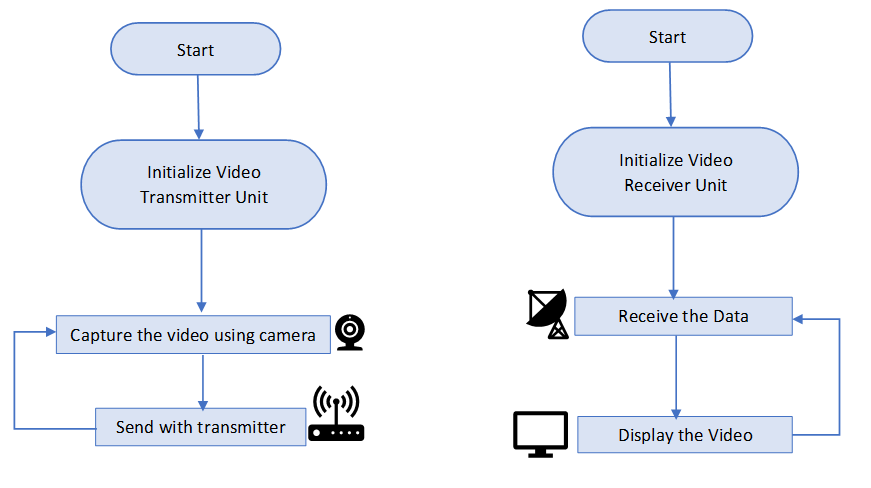
Drawings/flowchart_video.PNG
