canerpotur/TROY-TECH/Drawings/foto/IMG-5781.JPG

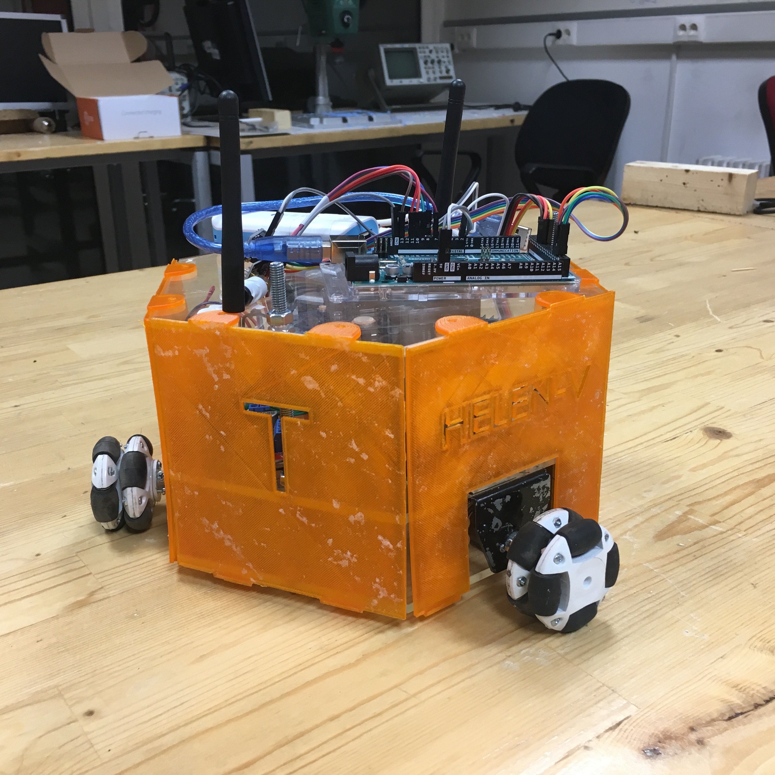
Drawings/foto/IMG-5781.JPG
