canerpotur/TROY-TECH/Drawings/foto/IMG-5783.jpg

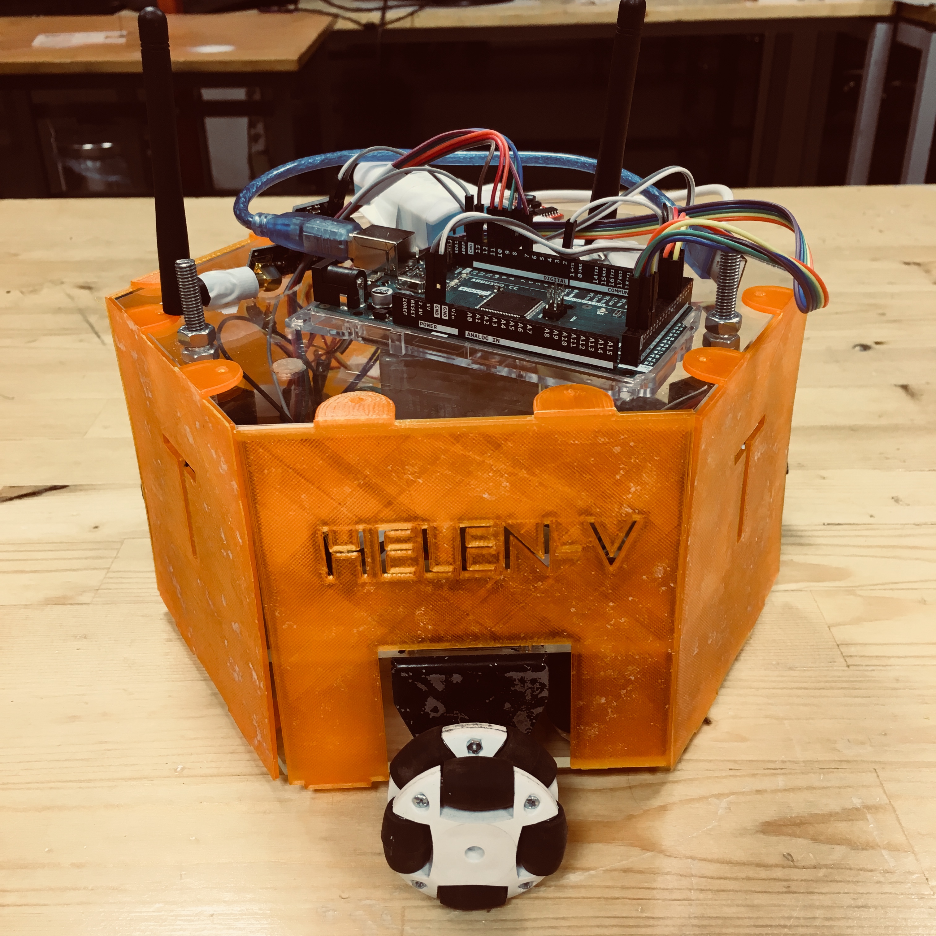
Drawings/foto/IMG-5783.jpg
