canerpotur/TROY-TECH/Drawings/foto/IMG-5784.jpg

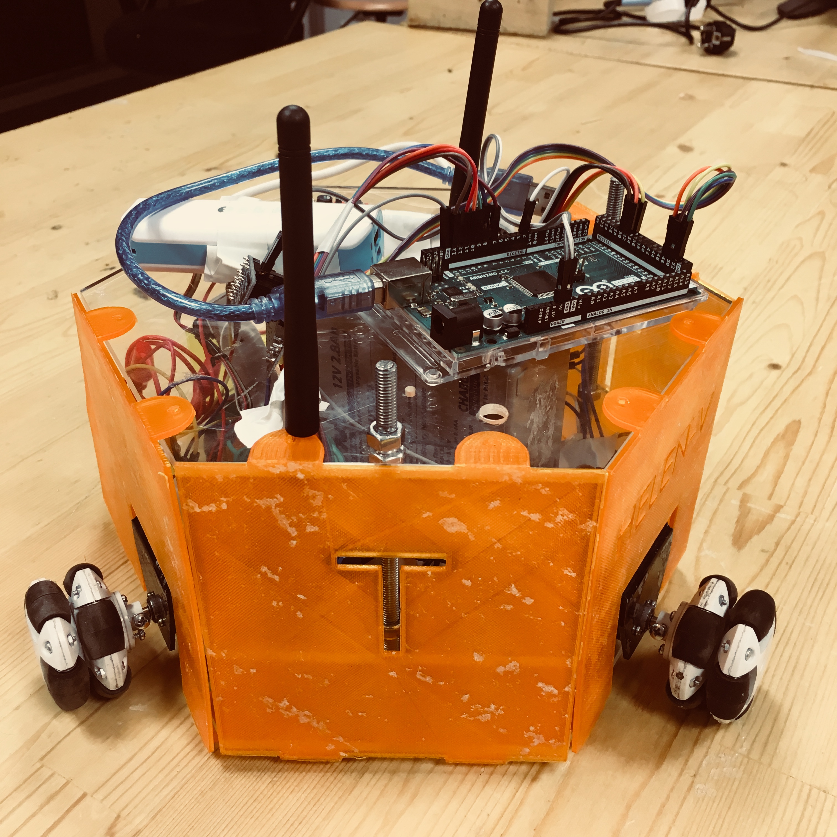
Drawings/foto/IMG-5784.jpg
