canerpotur/TROY-TECH/Drawings/gifs/gif_solenoid2.gif

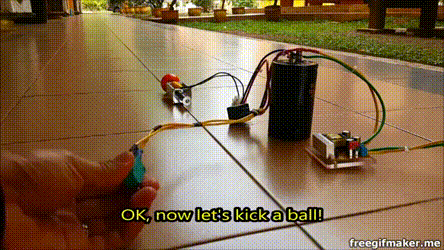
Drawings/gifs/gif_solenoid2.gif
