canerpotur/TROY-TECH/Drawings/gifs/gifsolenoid11.gif

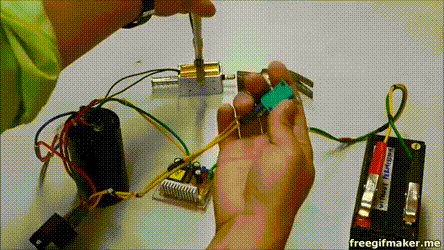
Drawings/gifs/gifsolenoid11.gif
