canerpotur/TROY-TECH/Drawings/gifs/gifspring2.gif

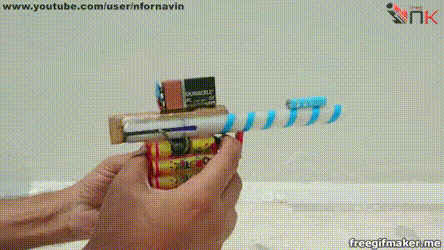
Drawings/gifs/gifspring2.gif
