canerpotur/TROY-TECH/Drawings/gifs/gifspring22.gif

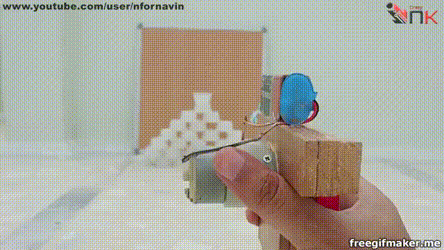
Drawings/gifs/gifspring22.gif
