canerpotur/TROY-TECH/Drawings/gifs/gifspring.gif

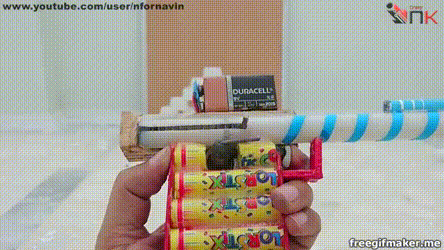
Drawings/gifs/gifspring.gif
