canerpotur/TROY-TECH/Drawings/gifs/motorgif.gif

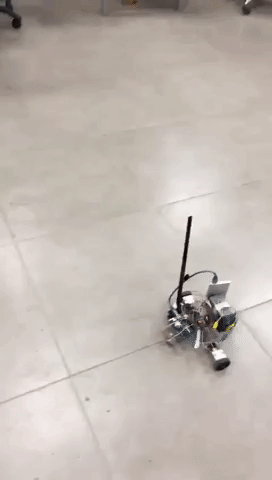
Drawings/gifs/motorgif.gif
