canerpotur/TROY-TECH/Drawings/ImageMountingApparatus.jpeg

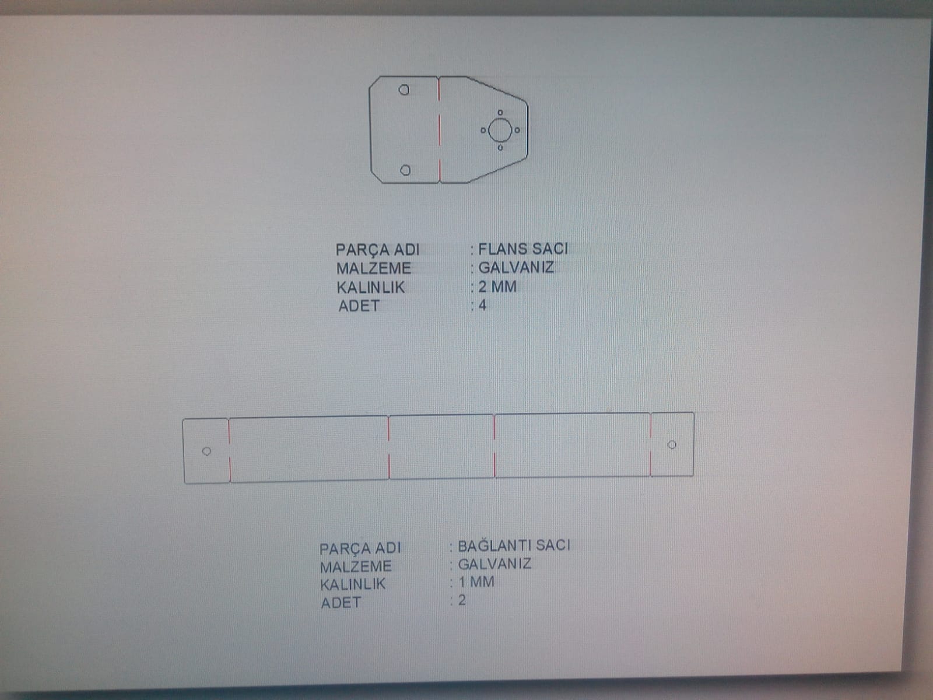
Drawings/ImageMountingApparatus.jpeg
