canerpotur/TROY-TECH/Drawings/lefthelen.JPG

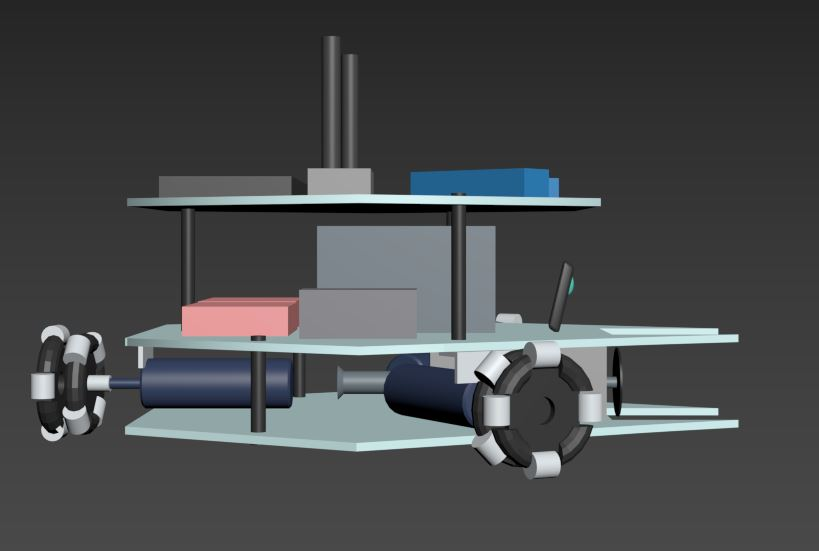
Drawings/lefthelen.JPG
