canerpotur/TROY-TECH/Drawings/omni-wheel2.png

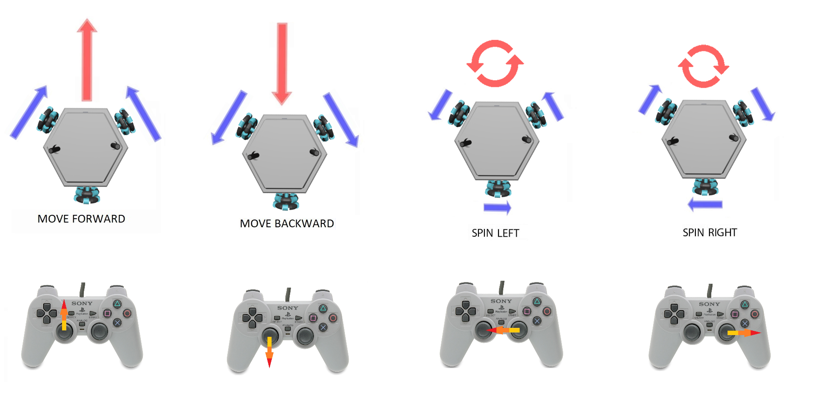
Drawings/omni-wheel2.png
