canerpotur/TROY-TECH/Drawings/omni-wheel,left,right.png

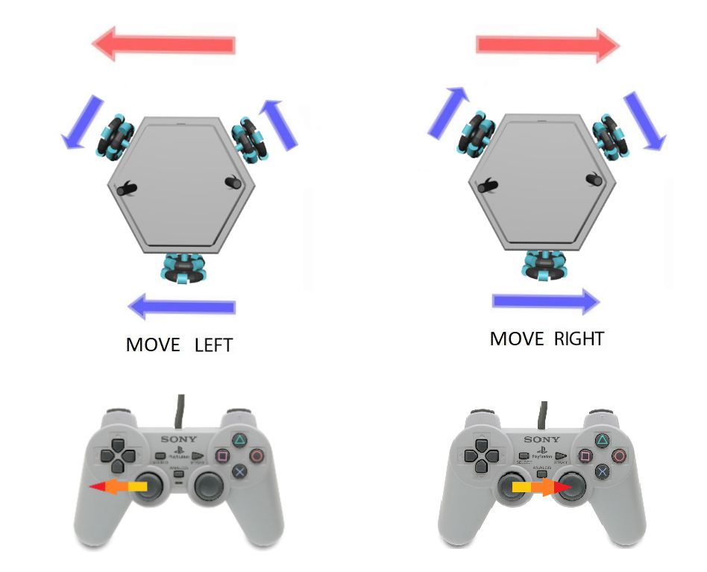
Drawings/omni-wheel,left,right.png
