canerpotur/TROY-TECH/Drawings/omni-wheel.png

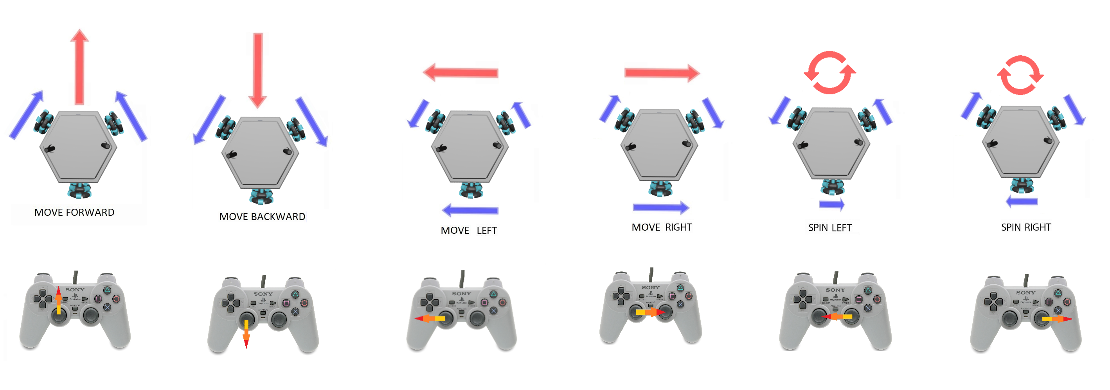
Drawings/omni-wheel.png
