canerpotur/TROY-TECH/Drawings/Power Supply Scheme.png

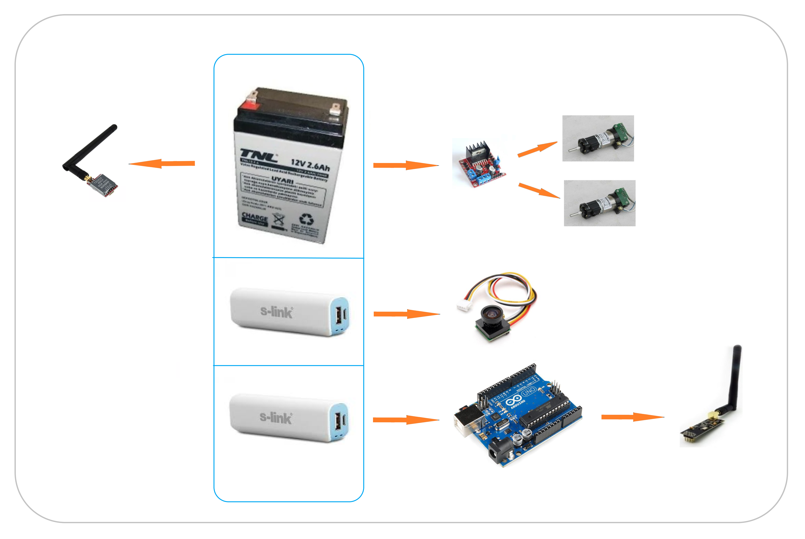
Drawings/Power Supply Scheme.png
