canerpotur/TROY-TECH/Drawings/ps1back.jpg

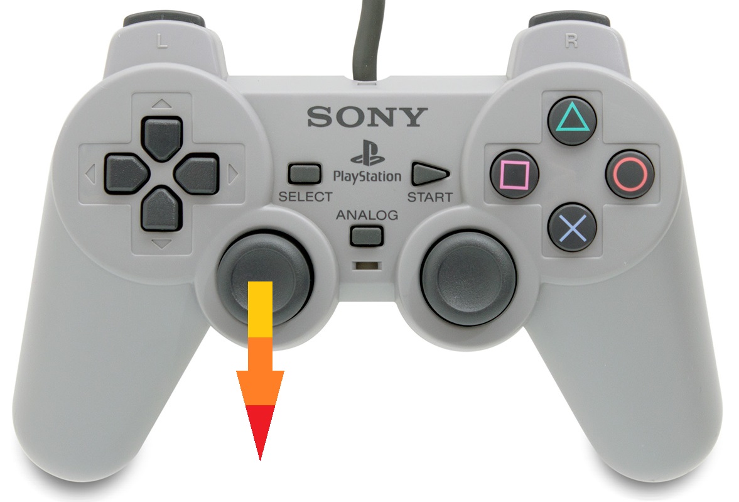
Drawings/ps1back.jpg
