canerpotur/TROY-TECH/Drawings/ps1forward.jpg

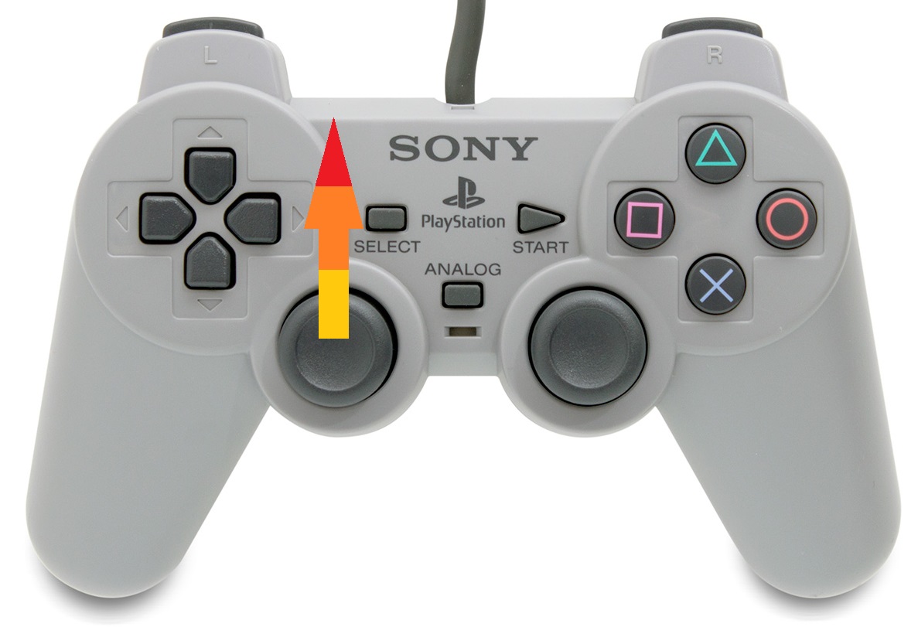
Drawings/ps1forward.jpg
