canerpotur/TROY-TECH/Drawings/ps1left.jpg

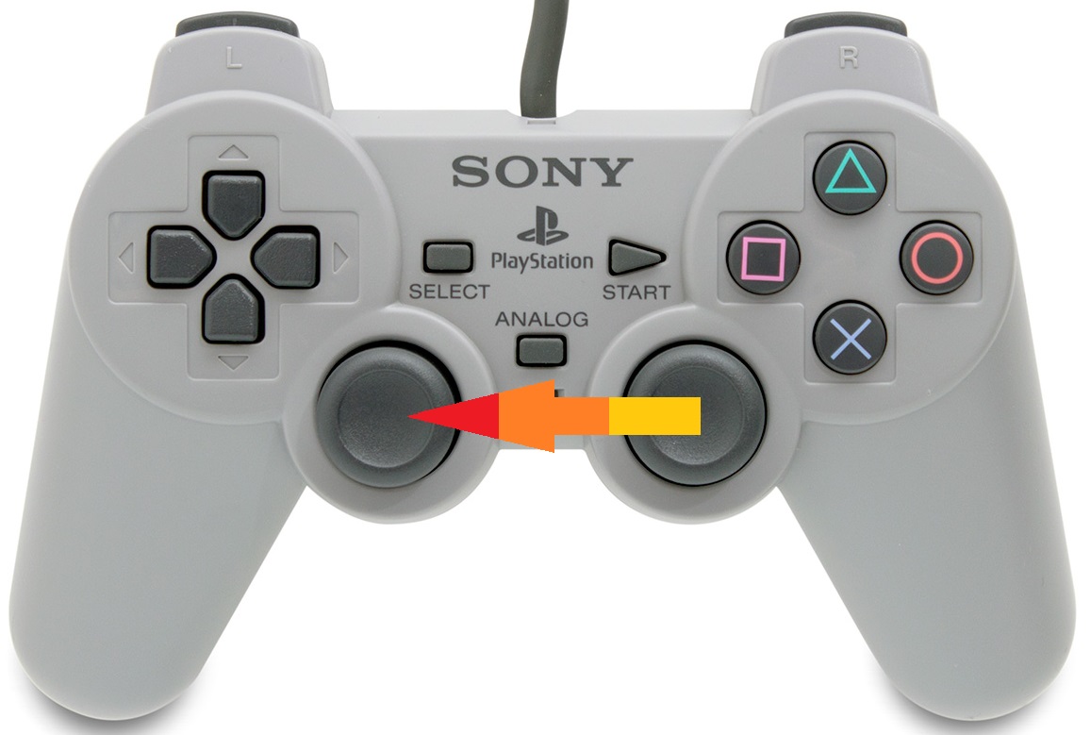
Drawings/ps1left.jpg
