canerpotur/TROY-TECH/Drawings/sony_ps1_dual_analog-8465.jpg

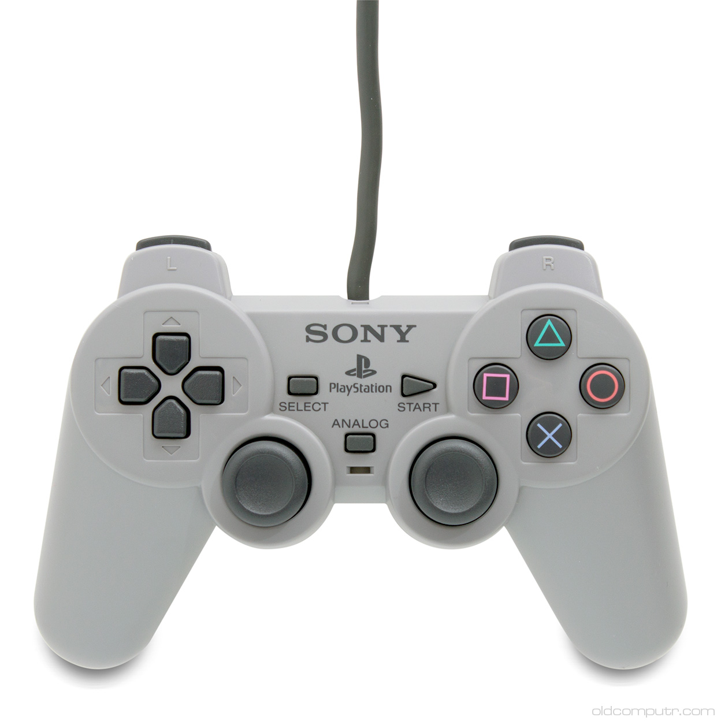
Drawings/sony_ps1_dual_analog-8465.jpg
