canerpotur/TROY-TECH/Implementation Pictures/LowerandMidBodyPartswithDCmotorsOmniwheels.jpeg

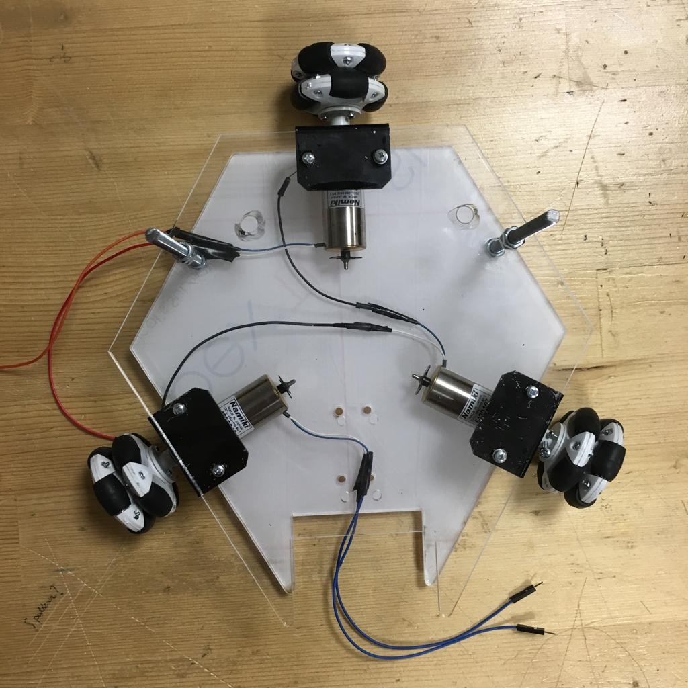
Implementation Pictures/LowerandMidBodyPartswithDCmotorsOmniwheels.jpeg
