canerpotur/TROY-TECH/Implementation Pictures/LowerBodyPlexiGlass.jpeg

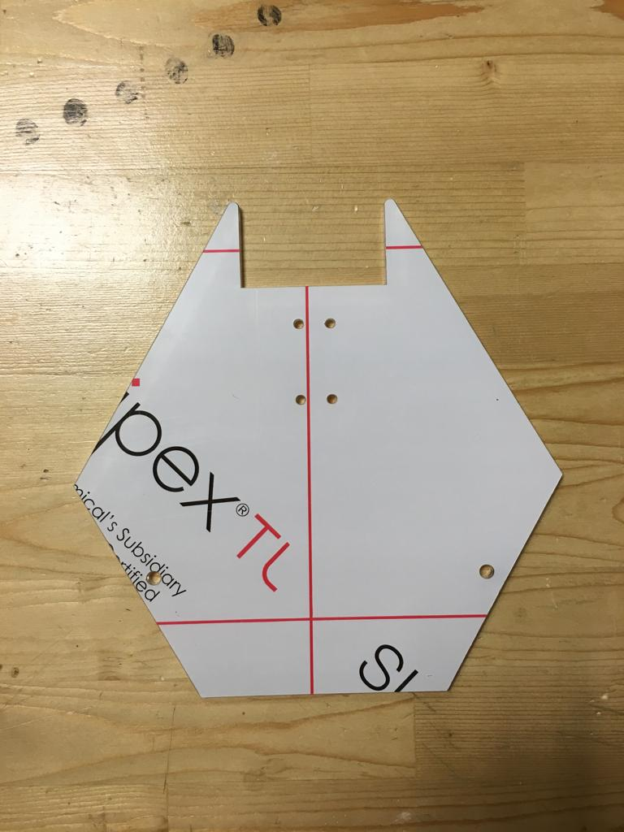
Implementation Pictures/LowerBodyPlexiGlass.jpeg
