canerpotur/TROY-TECH/Implementation Pictures/Middle body with omniwheels.jpeg

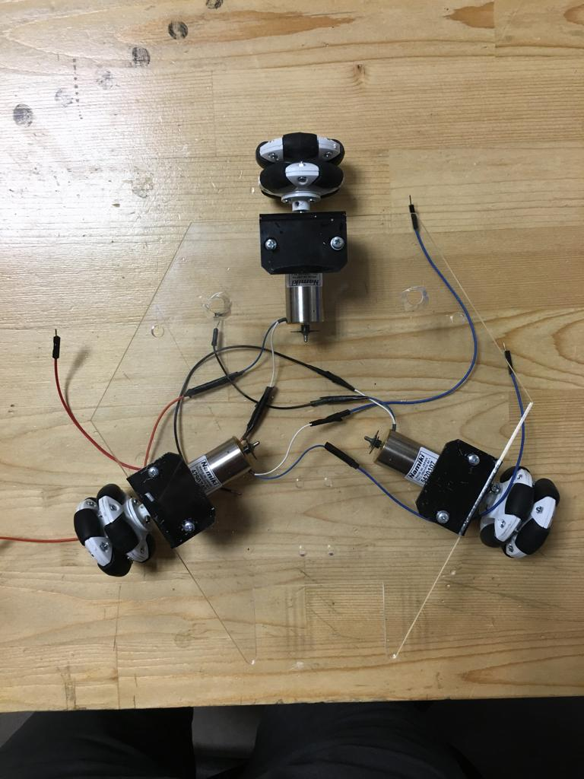
Implementation Pictures/Middle body with omniwheels.jpeg
