canerpotur/TROY-TECH/Implementation Pictures/MiddleBodyPlexiGlass.jpeg

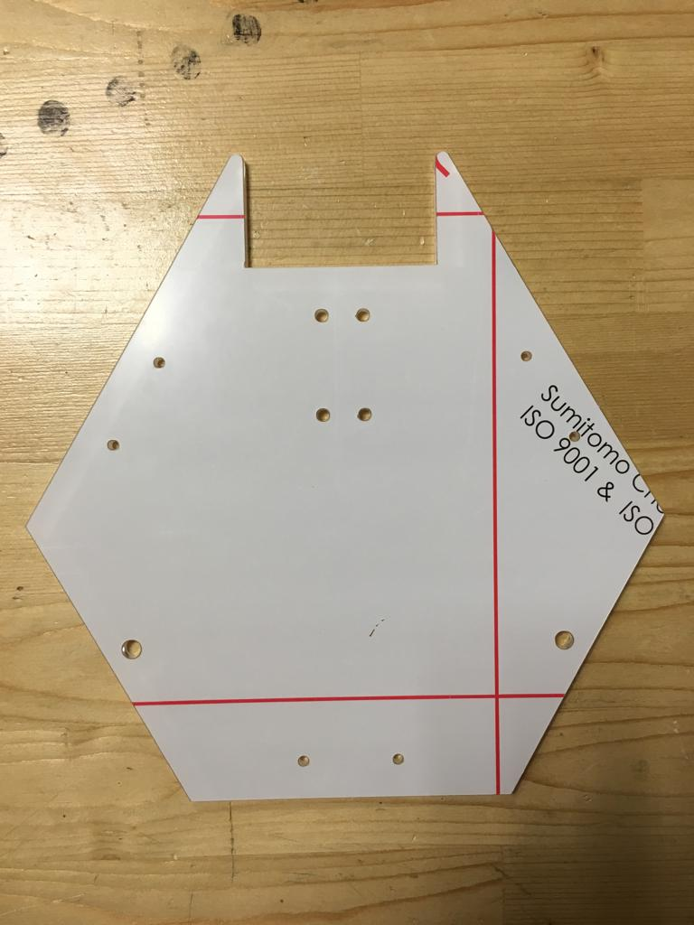
Implementation Pictures/MiddleBodyPlexiGlass.jpeg
