canerpotur/TROY-TECH/Implementation Pictures/Need-Implementation_V1_Front.jpg

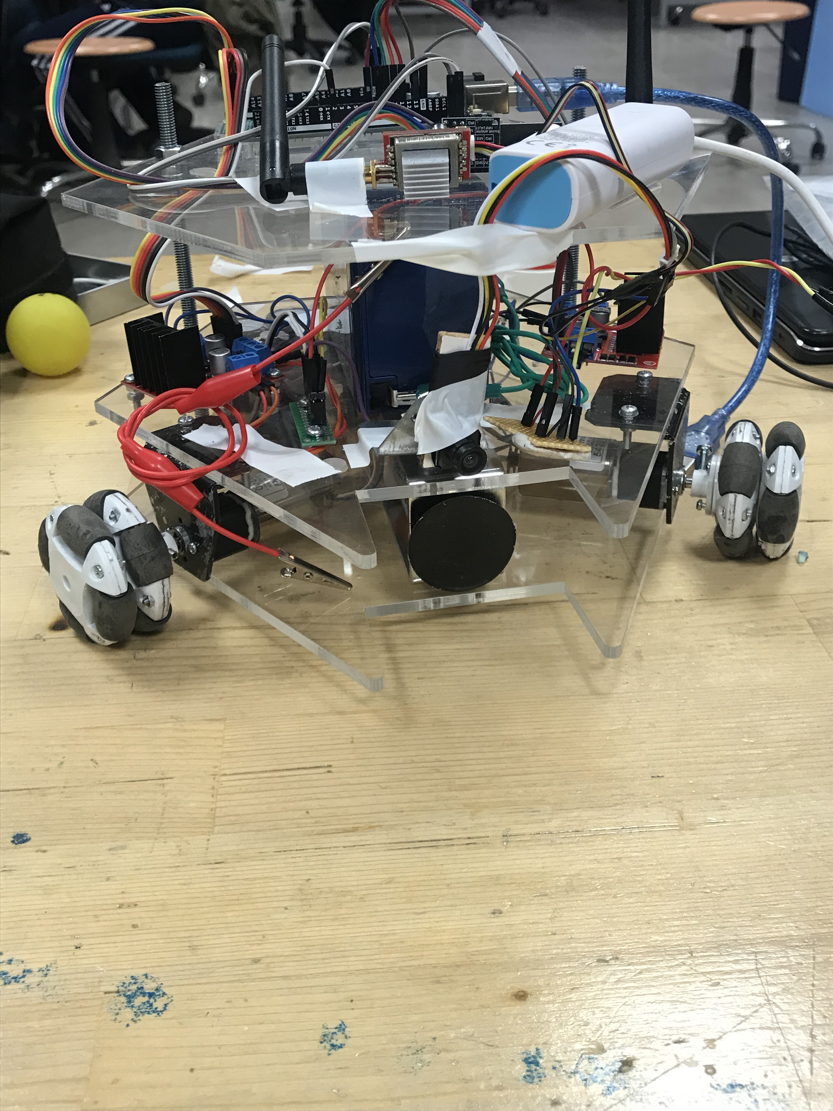
Implementation Pictures/Need-Implementation_V1_Front.jpg
