canerpotur/TROY-TECH/Implementation Pictures/Need_Implementation_V1_Top.jpg

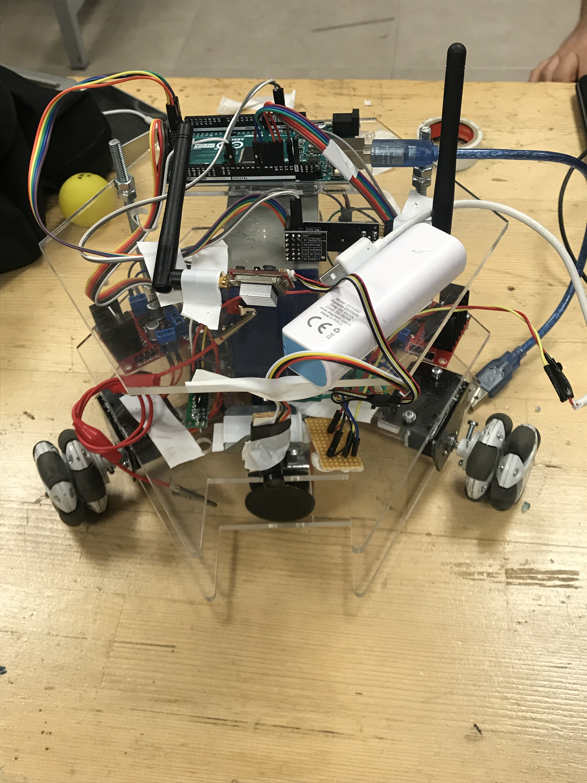
Implementation Pictures/Need_Implementation_V1_Top.jpg
