canerpotur/TROY-TECH/Implementation Pictures/ShootingSystemCircuitBoard_001.JPG

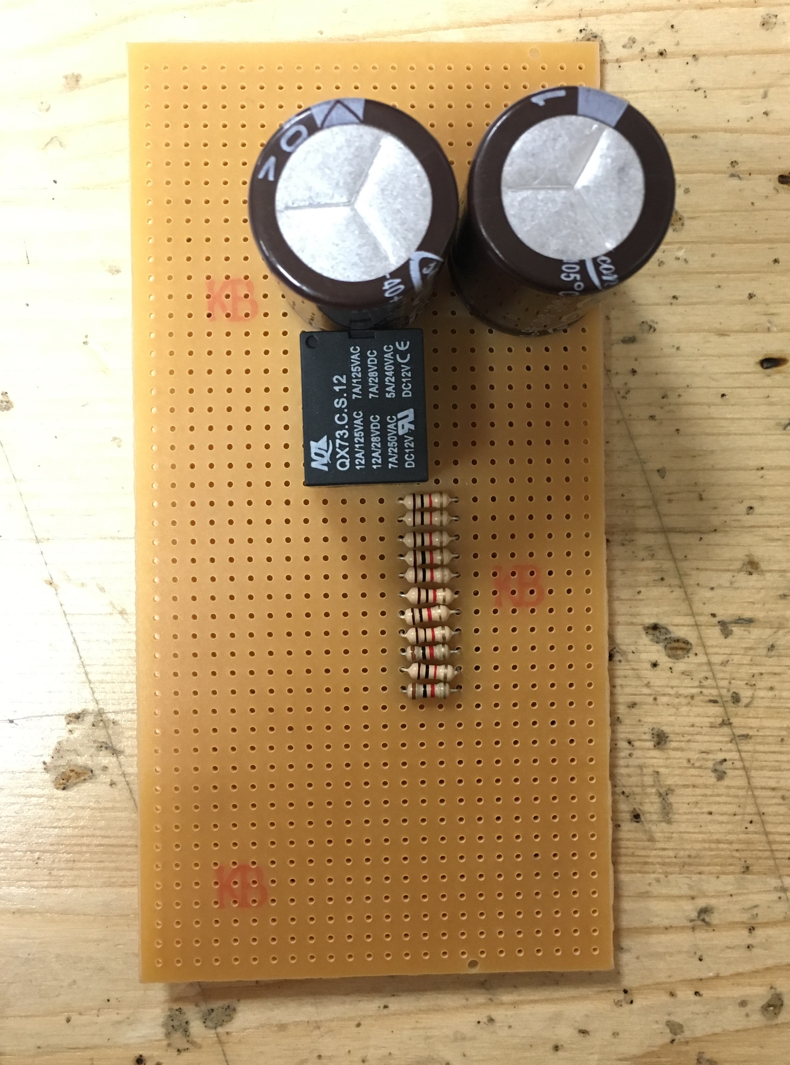
Implementation Pictures/ShootingSystemCircuitBoard_001.JPG
