canerpotur/TROY-TECH/Implementation Pictures/ShootingSystemCircuitBoard_002.JPG

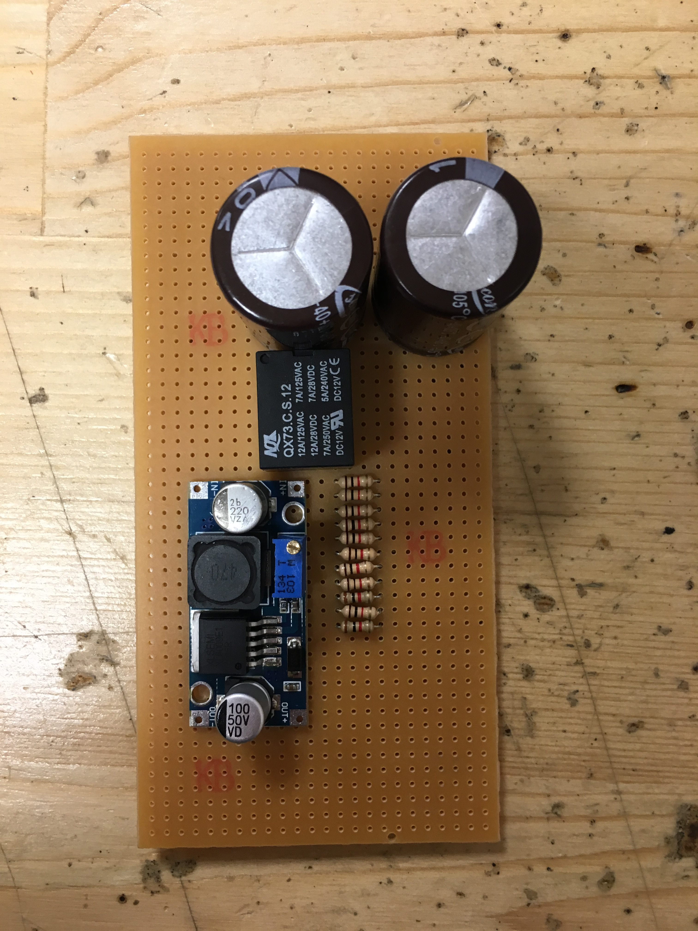
Implementation Pictures/ShootingSystemCircuitBoard_002.JPG
