canerpotur/TROY-TECH/Implementation Pictures/ShootingSystemCircuitBoard_003.JPG

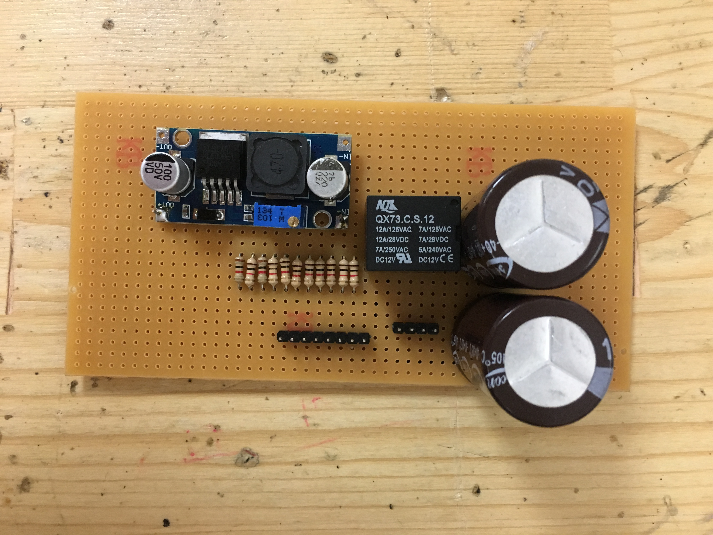
Implementation Pictures/ShootingSystemCircuitBoard_003.JPG
