canerpotur/TROY-TECH/Implementation Pictures/ShootingSystemCircuitBoard_004.jpg

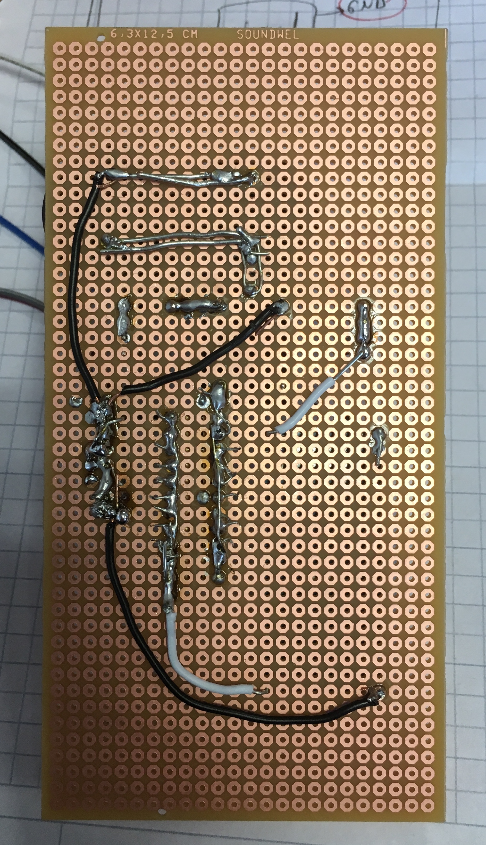
Implementation Pictures/ShootingSystemCircuitBoard_004.jpg
