canerpotur/TROY-TECH/Implementation Pictures/ShootingSystemCircuitBoard_006.JPG

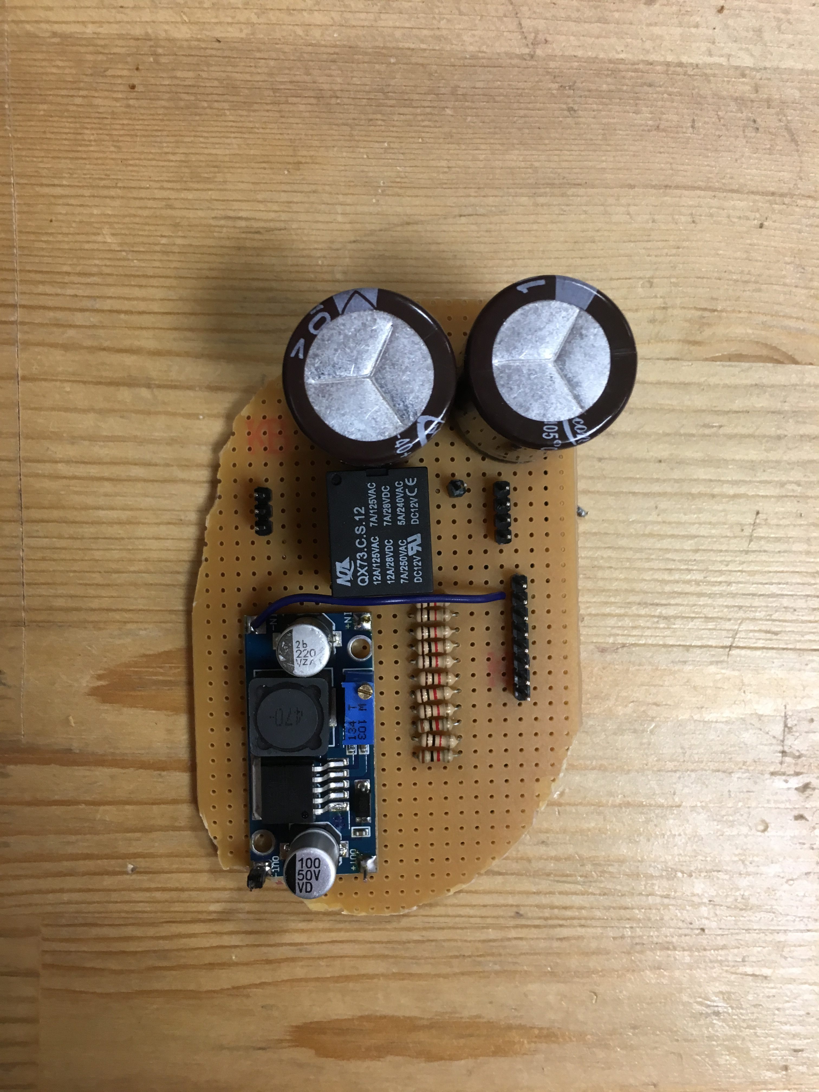
Implementation Pictures/ShootingSystemCircuitBoard_006.JPG
