canerpotur/TROY-TECH/Implementation Pictures/ShootingSystemCircuitBoard_007.JPG

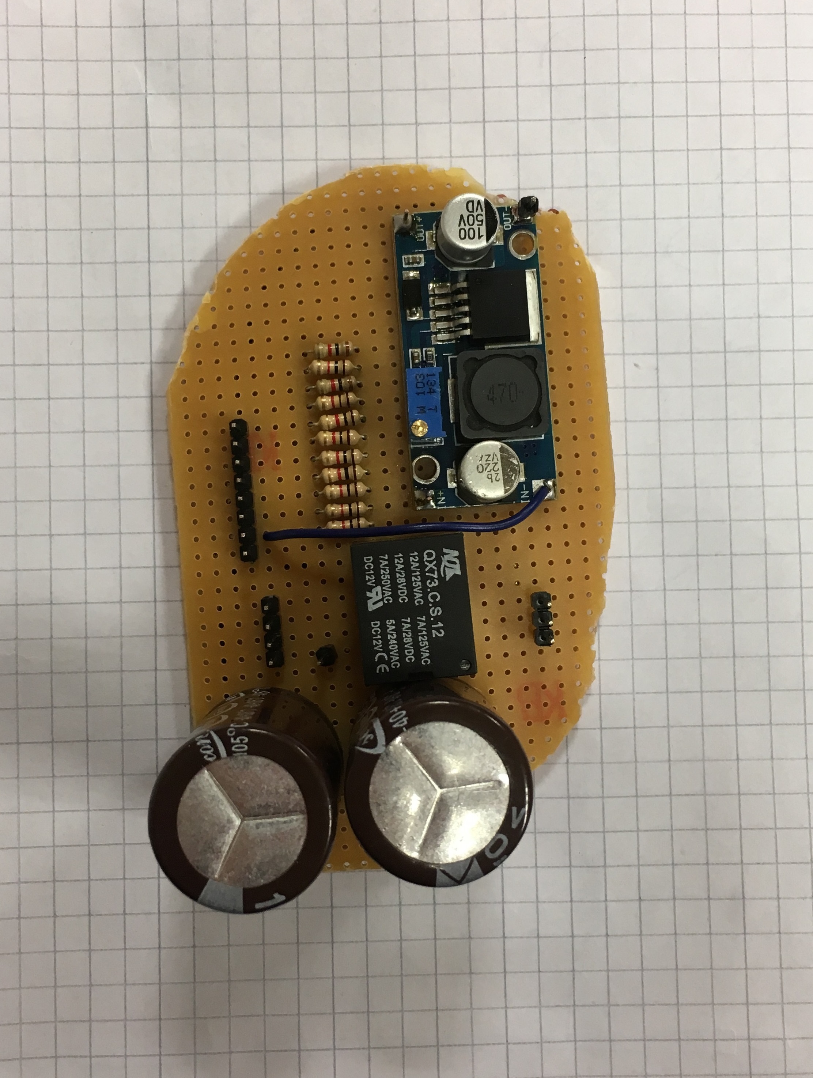
Implementation Pictures/ShootingSystemCircuitBoard_007.JPG
