canerpotur/TROY-TECH/Implementation Pictures/ShootingSystemCircuitBoard_008.JPG

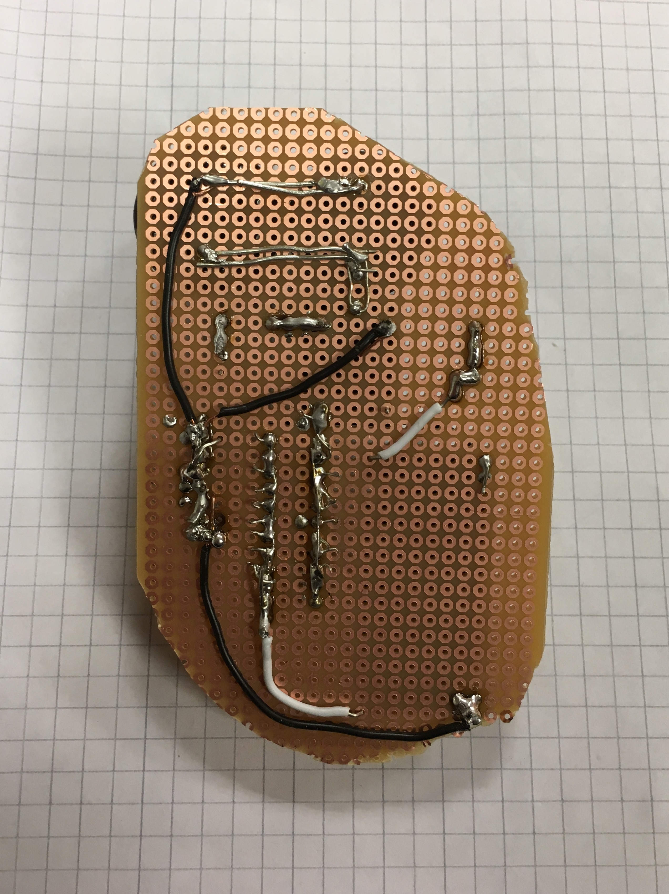
Implementation Pictures/ShootingSystemCircuitBoard_008.JPG
