canerpotur/TROY-TECH/Implementation Pictures/ShootingSystemCircuitBoard_009.jpg

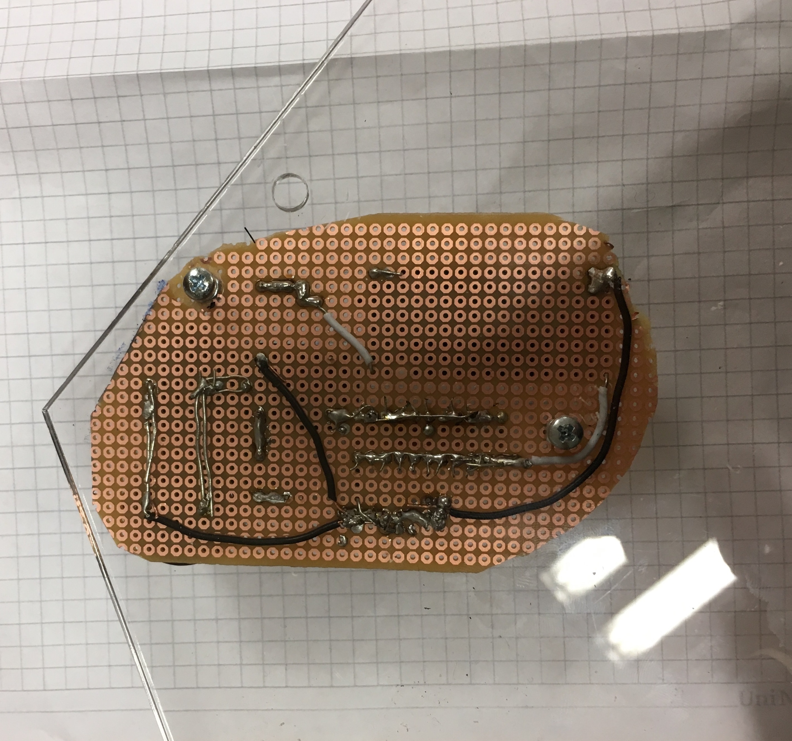
Implementation Pictures/ShootingSystemCircuitBoard_009.jpg
