canerpotur/TROY-TECH/Implementation Pictures/ShootingSystemCircuitBoardwithSolenoid001.JPG

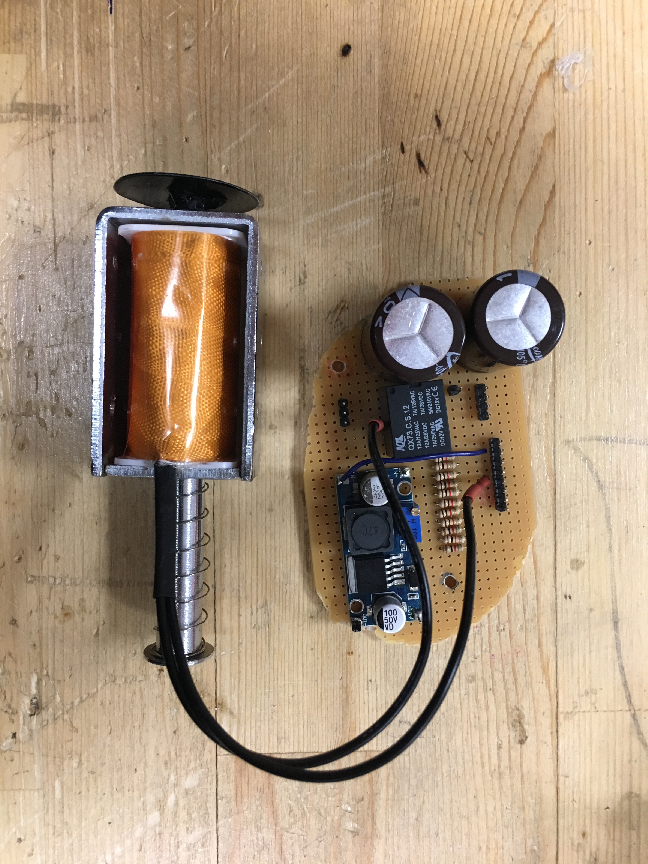
Implementation Pictures/ShootingSystemCircuitBoardwithSolenoid001.JPG
