canerpotur/TROY-TECH/Implementation Pictures/ShootingSystemCircuitBoardwithSolenoid002.JPG

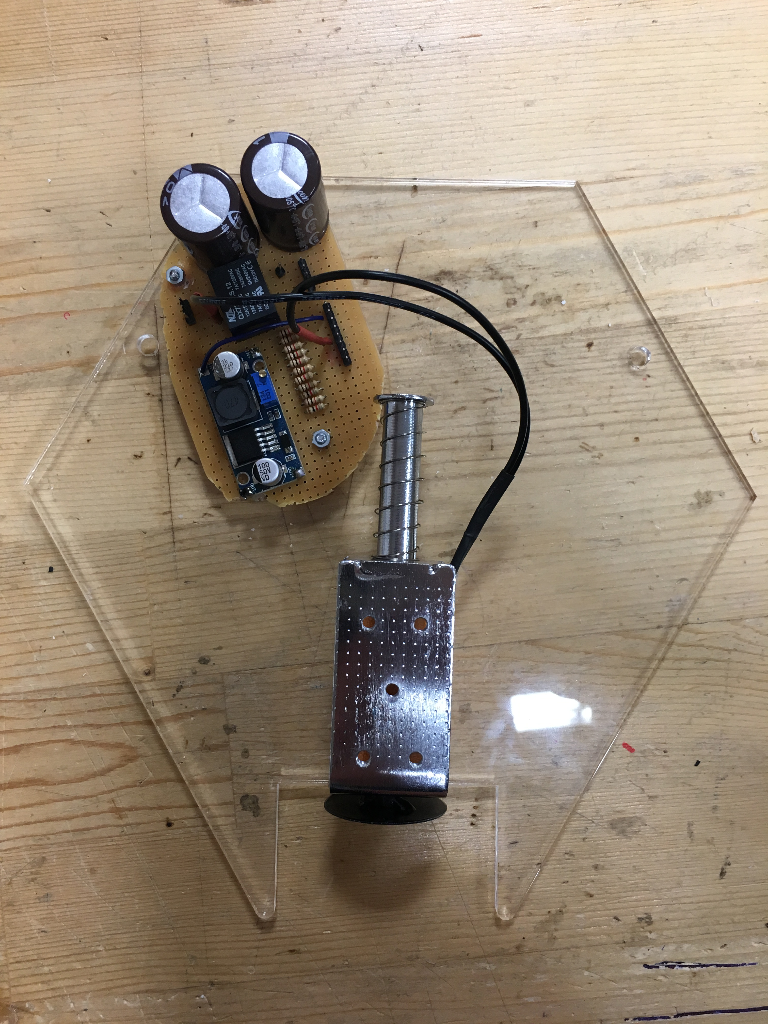
Implementation Pictures/ShootingSystemCircuitBoardwithSolenoid002.JPG
