canerpotur/TROY-TECH/Implementation Pictures/TopBodyPlexiGlass.jpeg

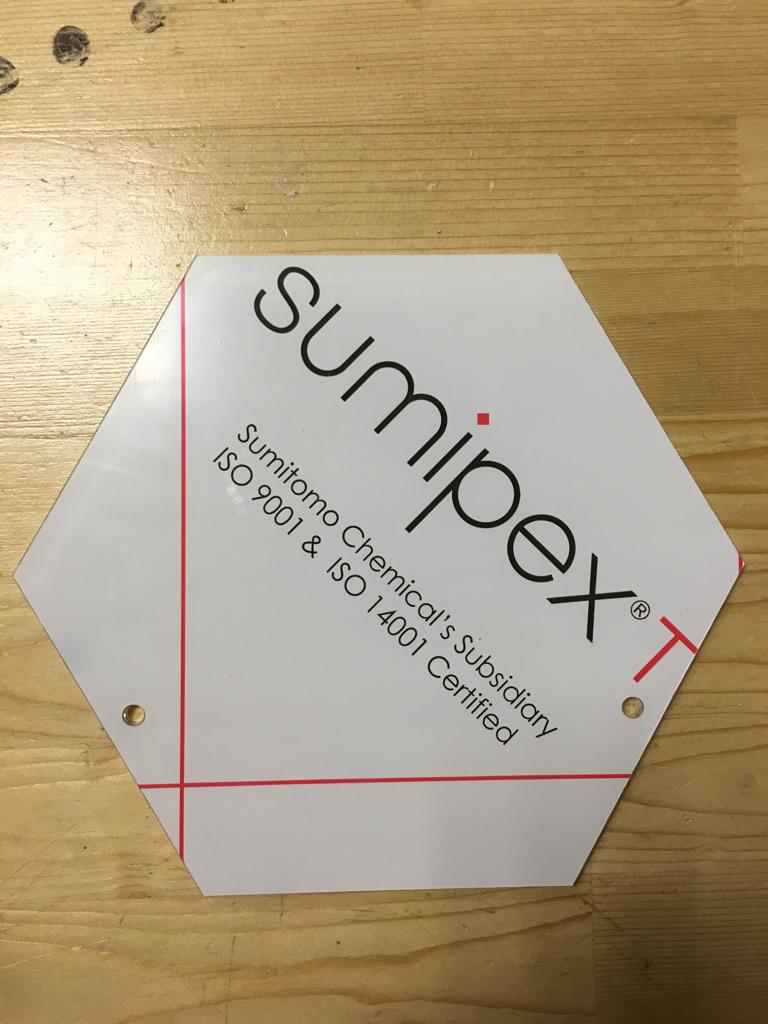
Implementation Pictures/TopBodyPlexiGlass.jpeg
