canerpotur/TROY-TECH/Searches/Encoder/encoder-pin2.jpg

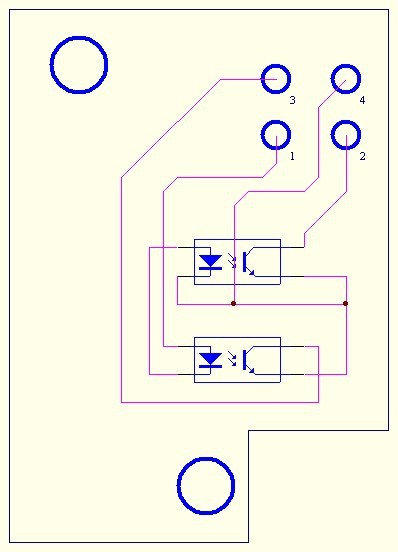
Searches/Encoder/encoder-pin2.jpg
