canerpotur/TROY-TECH/Searches/Encoder/encoder-pin.jpg

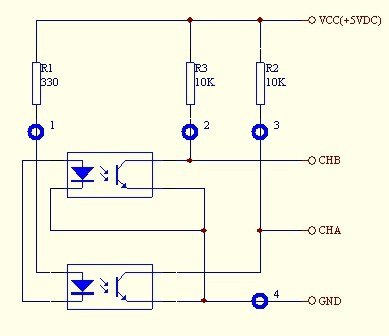
Searches/Encoder/encoder-pin.jpg
