canerpotur/TROY-TECH/Searches/PS1 Joystick/schematic.bmp

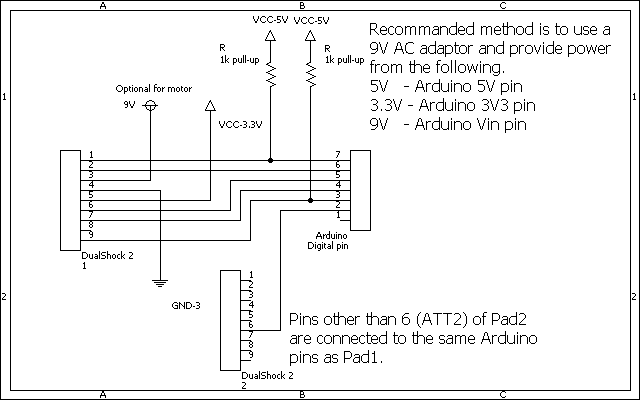
Searches/PS1 Joystick/schematic.bmp
