canerpotur/TROY-TECH/Searches/shooting systems/L298N_pins.PNG

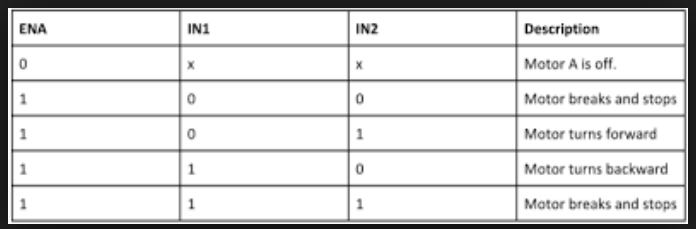
Searches/shooting systems/L298N_pins.PNG
