canerpotur/TROY-TECH/Searches/shooting systems/shooting_relay.jpg

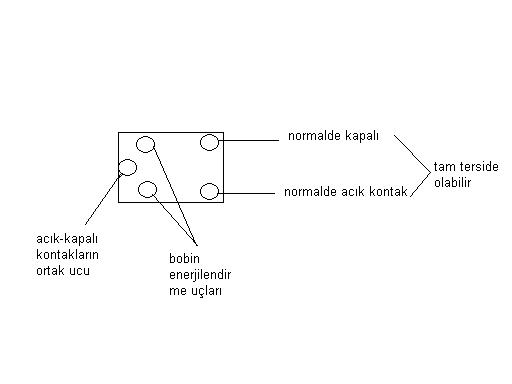
Searches/shooting systems/shooting_relay.jpg
