canerpotur/TROY-TECH/Searches/shooting systems/Solenoid circuit .png

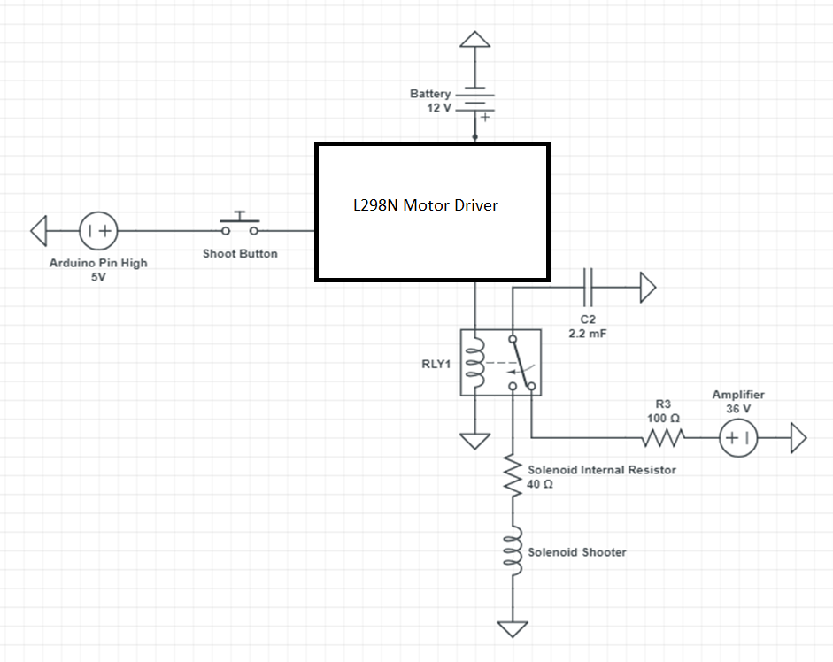
Searches/shooting systems/Solenoid circuit .png
