canerpotur/TROY-TECH/Searches/shooting systems/SPDT relay.jpg

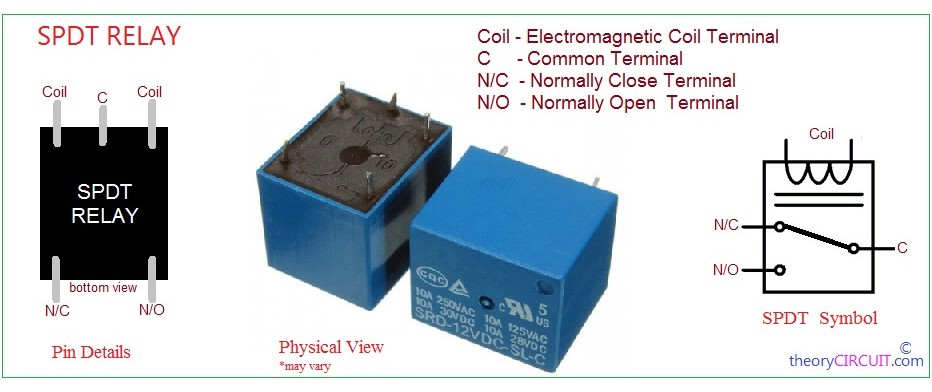
Searches/shooting systems/SPDT relay.jpg
