canerpotur/TROY-TECH/(list of files, cad)

Other CAD files:
Drawings/bağlantı_parçaları.dwg
Drawings/final_çizimler2d.dwg
Drawings/pleksi_kesim.dwg
