canerpotur/TROY-TECH/Drawings/User Manual Drawings/powersystem-3.png

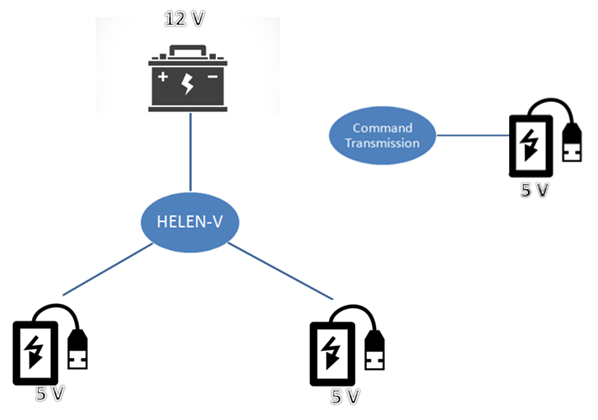
Drawings/User Manual Drawings/powersystem-3.png
