canerpotur/TROY-TECH/Drawings/User Manual Drawings/QuickStart.png

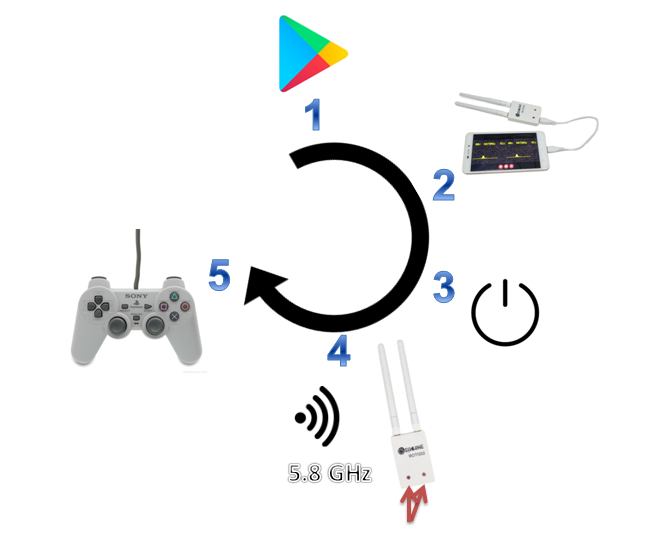
Drawings/User Manual Drawings/QuickStart.png
