canerpotur/TROY-TECH/Tests/shooting performance test/shooting tests.txt

speed:204.54 cm/s
range:+600 cm
charging duration of capacitor: 3.4 second
