canerpotur/TROY-TECH/Tests/Range performance  Video+command  tests/command tests.txt

indoor:58.7 meters (Inside D-building)- 69.57 meters (Between D-E buildings)
outdoor:237.6 meters
