canerpotur/TROY-TECH/Tests/Range performance  Video+command  tests/video tests.txt

indoor: 56.11 meters (Inside D building)- 67.58 meters (Between D-E buildings)
Outdoor: 237.76 meters
