canerpotur/TROY-TECH/Camera Views/camera view_test.jpeg

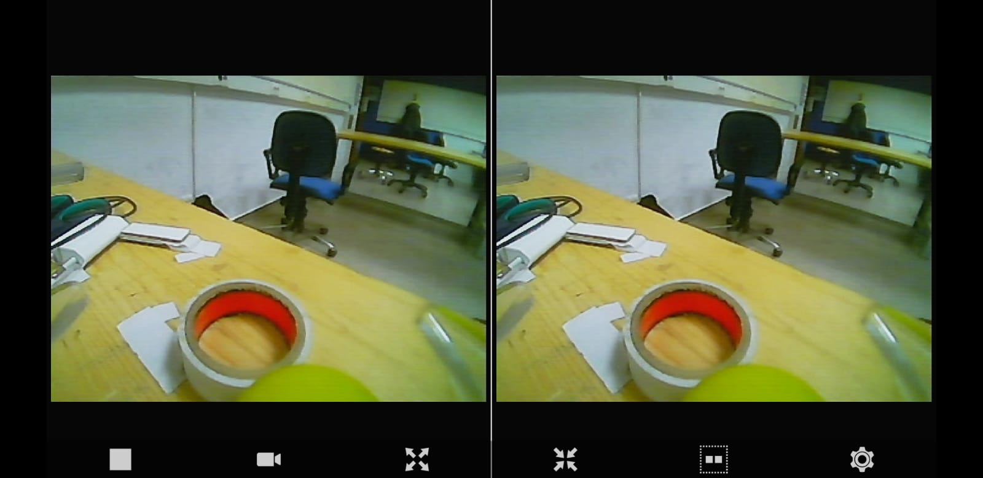
Camera Views/camera view_test.jpeg
