canerpotur/TROY-TECH/Spring Semester Test Results/08_04_2019_CommandTransmission_IndoorRangeTest_Successful.JPG

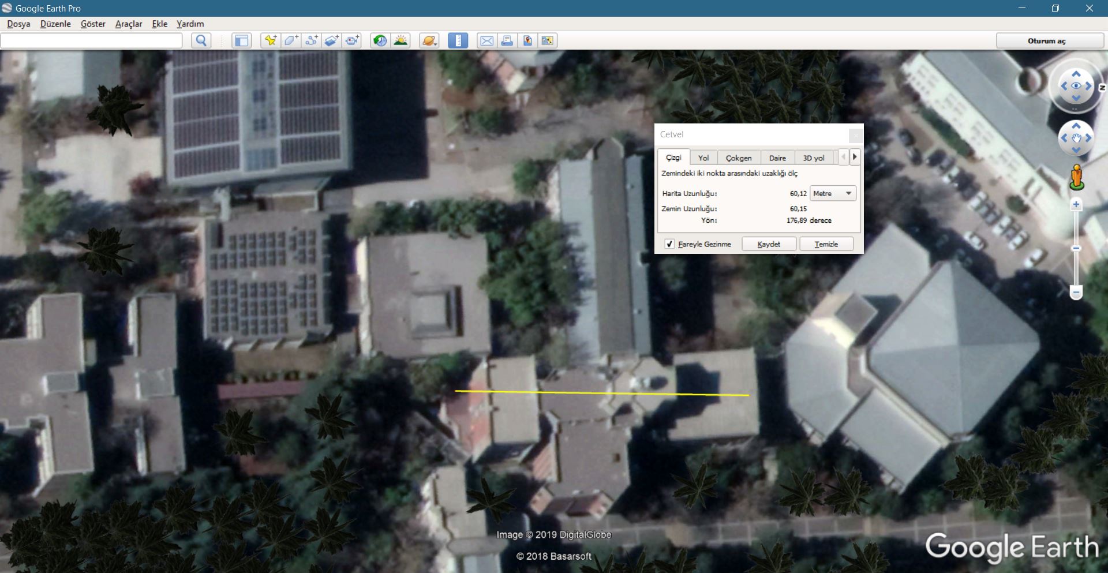
Spring Semester Test Results/08_04_2019_CommandTransmission_IndoorRangeTest_Successful.JPG
