canerpotur/TROY-TECH/Tests/Range performance  Video+command  tests/Photos (Google Earth)/D_command.JPG

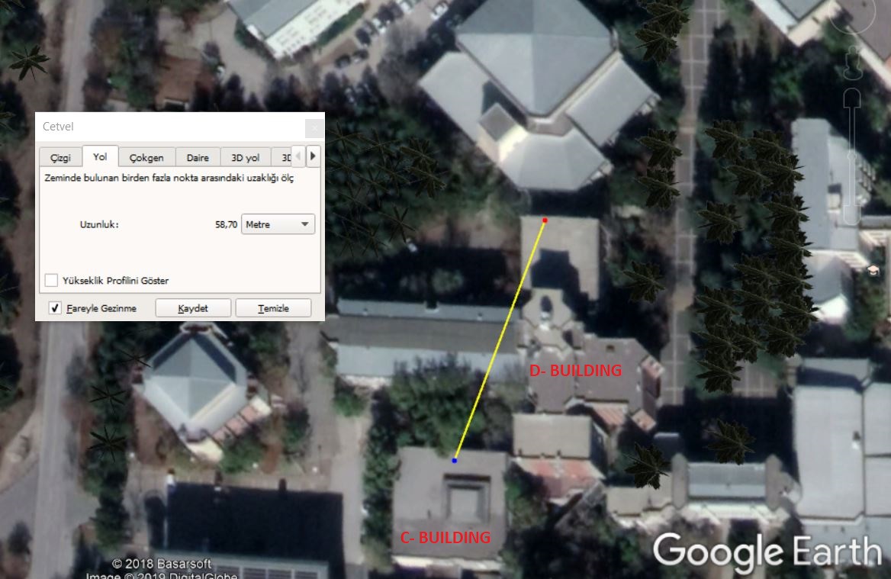
Tests/Range performance Video+command tests/Photos (Google Earth)/D_command.JPG
