canerpotur/TROY-TECH/Tests/Range performance  Video+command  tests/Photos (Google Earth)/D_E_video.JPG

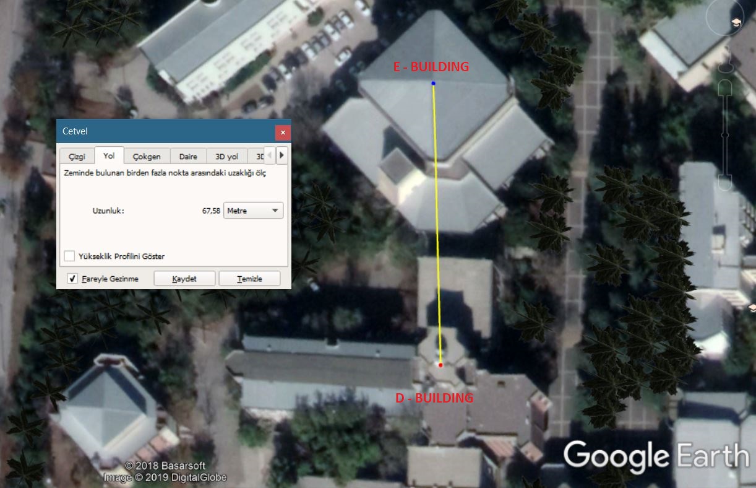
Tests/Range performance Video+command tests/Photos (Google Earth)/D_E_video.JPG
