canerpotur/TROY-TECH/Tests/Range performance  Video+command  tests/Photos (Google Earth)/outdoor.JPG

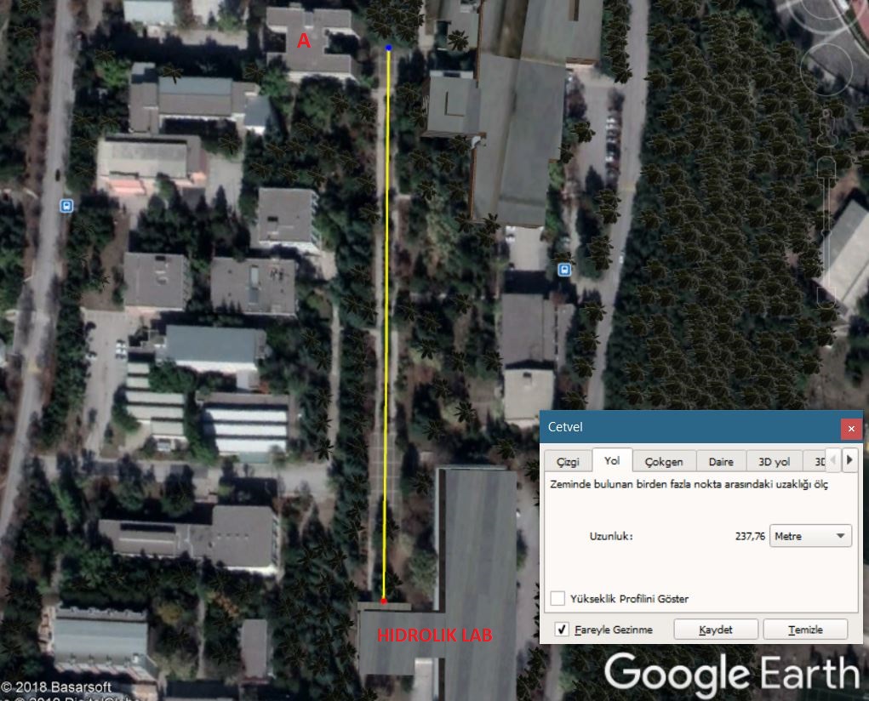
Tests/Range performance Video+command tests/Photos (Google Earth)/outdoor.JPG
