canerpotur/TROY-TECH/(commit log)

2018-10-16 Arduino Wireless Communication Module
2018-10-16 Rename ss to Wireless Module for remote control
2018-10-16 Update and rename Wireless Module for remote control to remote control communication
2018-10-22 important words and devices updated
2018-10-22 devices here
2018-10-29 Detailed article about omni wheel
2018-10-29 add omni-wheel to devices
2018-10-29 DEVICES.docx is updated. Some subfolders are created
2018-11-14 Update Searches/Wireless Transmission/Researches on Command Transmission.docx
    command control researches file
2018-11-14 Update Searches/Wireless Transmission/Researches on Command Transmission.docx
    update
2018-11-14 Update Searches/Wireless Transmission/Researches on Command Transmission.docx
2018-11-14 Update Searches/Wireless Transmission/Avoiding interference in 2.4GHz.docx
2018-11-14 Update Searches/Wireless Transmission/Researches on Command Transmission.docx
    I add a rc controller
2018-11-28 Arduino codes for nrf
2018-12-01 PS1 Joystick interface library for Arduino
2018-12-03 Update Videos on shooting.docx
    A sample ball shooting mechanism including spring is added.
2018-12-04 Arduino codes for using Encoder
2018-12-13 motor code uploaded
2018-12-13 Create useful link for motor drive.txt
2018-12-15 Create NRF24-receiver with leds.ino
2018-12-15 gear uploaded
2018-12-15 motor with 3 gear
2019-02-25 Solenoid Controlling Circuit Example
2019-03-04 Update omni-wheel test
2019-03-12 Update Kicking system.docx
    Force, Velocity and Energy of Solenoid Plunger diagram is added.
2019-03-12 shooting circuit drawings and relay
2019-03-28 Create Mounting Apparatus.txt
2019-03-28 Update Mounting Apparatus.txt
2019-03-28 mounting apparatus
2019-03-28 Create LowerandMidBodyPartswithDCmotorsOmniwheels.jpeg
    DC motors and Omniwheels are attached to the lower and middle body parts
2019-03-28 Solenoid Comparison
2019-03-29 Shooting_Test Arduino Code
2019-03-29 L298 Motor drive pins
2019-04-04 Create ShootingSystemCircuitBoardwithSolenoid001.JPG
    Solenoid cables are connected to the Shooting system control circuit.
2019-04-06 Drawings of the body pieces
    [bağlantı_parçaları.dwg, final_çizimler2d.dwg, pleksi_kesim.dwg]
2019-04-08 camera views
2019-04-08 camera and robot
2019-05-06 Power System image
2019-05-08 Update Power of subsystems.txt
2019-05-09 Power of subsystems is updated
2019-05-09 Update Final report.docx
    Overall power supply subsystem schematic is added.
2019-05-10 Update Solenoid circuit .png
2019-05-10 Update Final report.docx
    Power consumption
