canerpotur/TROY-TECH/Implementation Pictures/ShootingSystemCircuitBoard_005.JPG

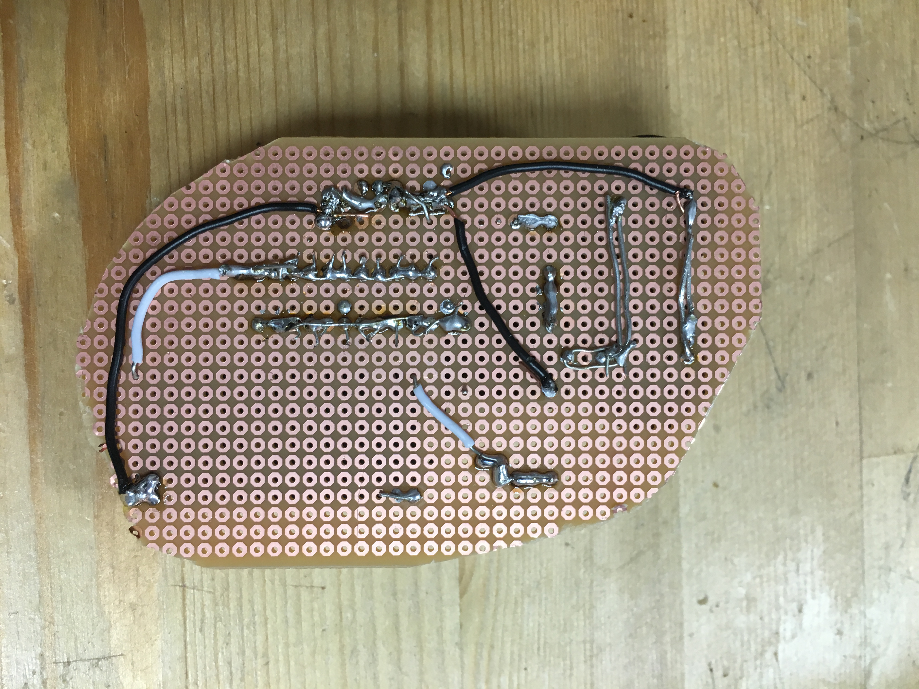
Implementation Pictures/ShootingSystemCircuitBoard_005.JPG
